tlee10333/card-dealer-final-project/README.md

# Automated Card Dealer Machine 
 By: Alex George, Ike Walker, Trinity Lee, Mo Ampane
## Principles of Integrated Engineering Final Group Project 

Our Project is to develop a automated card dealing machine using an Arduino Uno, a stepper Motor (NEMA 12 V), and a DC Motor.
