tlee10333/card-dealer-final-project/docs/pages/gallery.md

---
layout              : page-fullwidth
title               : "Gallery"
subheadline         : "Pictures &amp; Videos"
teaser              : "A gallery documenting visually our team's progress, from whiteboard sketches to prototypes."
header:
   image_fullwidth  : "header_roadmap_3.jpg"
permalink           : "/gallery/"

image:
   thumb: cadassembly-thumb.jpg
gallery:
    - image_url: cadassembly.jpg
      caption: The finished CAD of our card dealer with turning gear(not integrated into table)
    - image_url: action_shot.jpg
      caption: A picture of our final card dealer product in action  
    - image_url: bottom_pan_cad.jpg
      caption: A CAD layout of the bottom gears
    - image_url: dealer_side2.jpg
      caption: Picture of the card dealer with panning mechanism (before shroud)
    - image_url: IMG_5724.jpg
      caption: Picture of the card dealer fully integrated with the central column
    - image_url: isometric_pan_cad.jpg
      caption: CAD image of the elgonated support legs and panning mechanism
    - image_url: just_shooter.jpg
      caption: Our complete electrical integration of all motors and LCD Screen
    - image_url: lcd.jpg
      caption: An image of the final integrated LCD screen with buttons into the shroud   
    - image_url: schematic.jpg
      caption: Our Block Diagram showing the flow of actions for our system
    - image_url: schematic_diagram.jpg
      caption: The entire electrical system schematic diagram
    - image_url: table_complete_isometric.jpg
      caption: The complete Table (before integration)
    - image_url: cadassembly_table.jpg
      caption: A CAD screenshot of full table and card dealer integration
    - image_url: painted_center_support.jpg
      caption: A painted central support
    - image_url: product_image_2.jpg
      caption: Finished table and integrated card dealer being used by team members
    - image_url: product_image_3.jpg
      caption: Our integrated card dealer in action
    - image_url: real_dealer1.jpg
      caption: Close up of automatic card dealer (sans shroud) with cards
    - image_url: real_dealer2.jpg
      caption: Close up of automatic card dealer (sans shroud) without cards
    - image_url: caddealer.jpg  
      caption: CAD image of just the card dealing mechanism 
    - image_url: caddealershroud.jpg
      caption: CAD image of card dealing mechanism with shroud
    - image_url: internal_gear.jpg
      caption: Top view of turning gear mechanism setup
---

{% include gallery %}
