tlee10333/card-dealer-final-project/docs/_posts/system/2023-10-13-electrical.md

---
layout: page-fullwidth
title: "Electrical System Overview"
subheadline: "Overview"
teaser: "An overview of the Electrical System of the Automatic Card Dealer."
categories:
    - system
show_meta: false
header:
    title: Electrical System
    background-color: "#EFC94C;"
    image_fullwidth: IMG_5722.jpg

---
<!--more-->

## Harnessing & Electrical System Overview

At the core of our electrical system, we use an `Arduino Uno` and an `Adafruit Motor Shield v2` placed directly on top of the Arduino to drive all hardware and firmware. The Motor shield has the capacity to drive up to 4 DC motors or two stepper motors, so for our product, it was the perfect amount since we needed one stepper motor and one DC motor. 

On top of the motors, we also needed to use buttons with pull up resistors (debounce was handled in firmware)
Here is a schematic diagram that was used to keep track of all the harnessing and wiring for the auto dealer. It also lists on the right hand side the different pins used and the corresponding wiring for it.  

<div class="row ">
    <div class="columns">
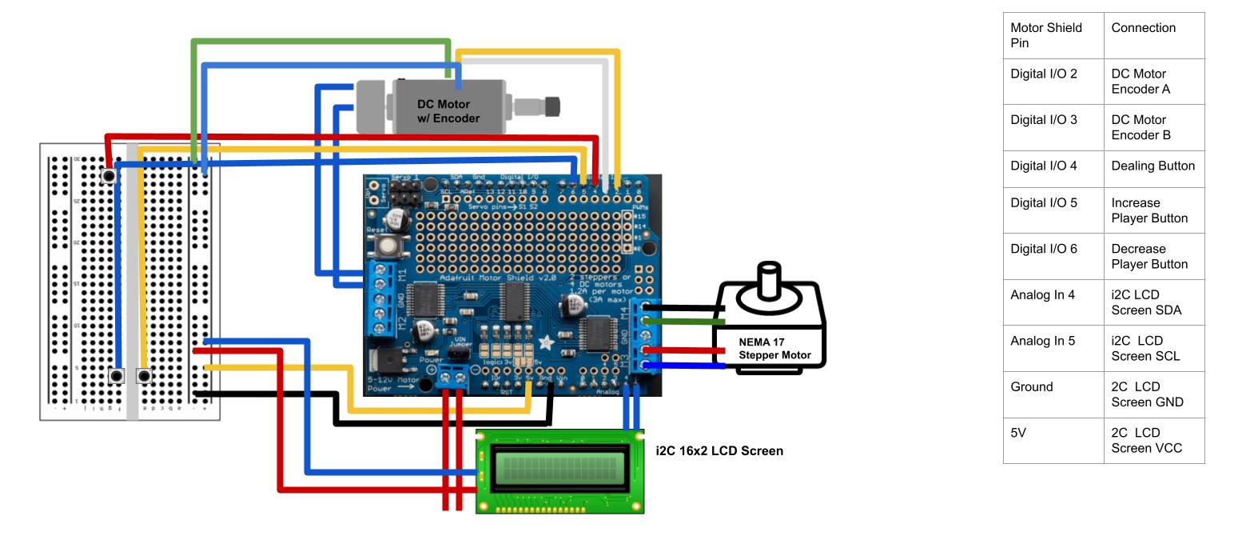
[picture p32: docs/images/schematic_diagram.jpg]
        <center>
        <p><i>  A schematic diagram of our electrical system </i></p></center>
    </div><!-- /.columns -->
</div><!-- /.row -->

This is integrated into the actual card dealer, with the arduino, motor shield, and breadboard living right under the card dealer and on the pan mechanism. Note that Digital I/O pins are used only for the encoder and the three different buttons, while the LCD screen uses Analog pins for the i2C protocol. 

<div class="row ">
    <div class="columns">
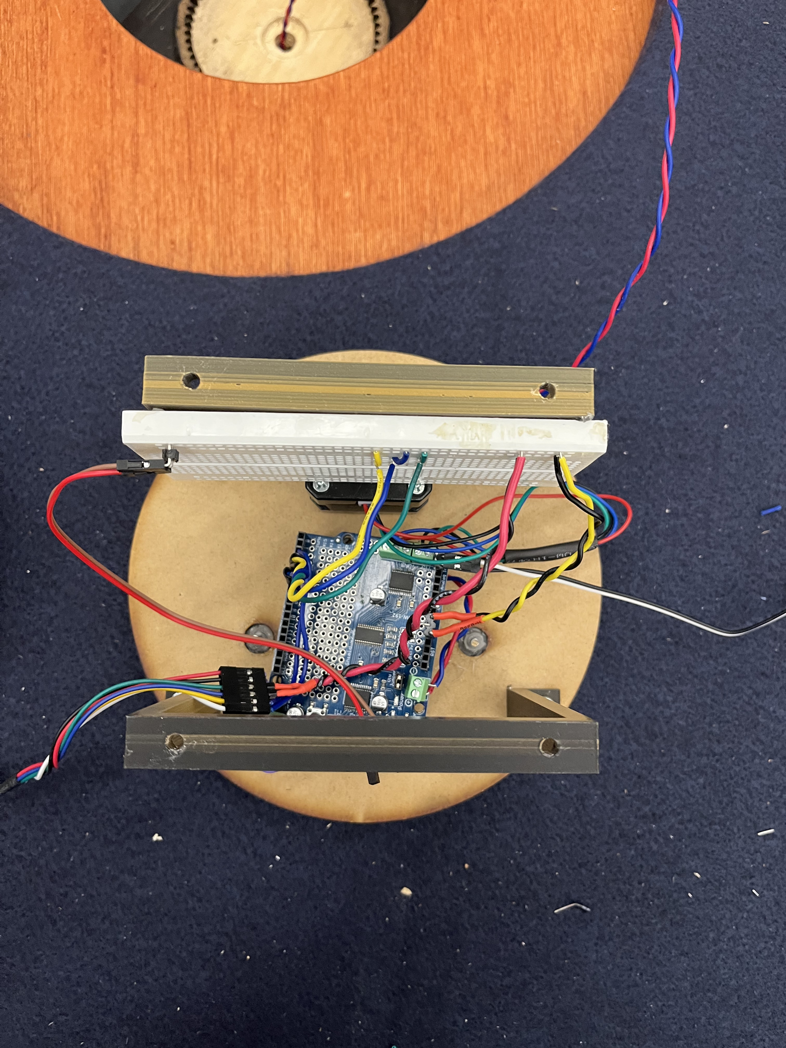
[picture p33: docs/images/IMG_5738.jpg]
        <center>
        <p><i>  A topview of our integrated electrical system </i></p></center>
    </div><!-- /.columns -->
</div><!-- /.row -->

The buttons and LCD Screen are embedded into the shroud, with wires soldered onto the buttons. The Arduino and the motor shield is powered through a AC power supply that is directly connected to the motor shield. The wires connecting the AC power supply to the Arduino go through a hole into the central column. 

<center>
<div class="row t60">
    <div class="medium-6 columns b30">
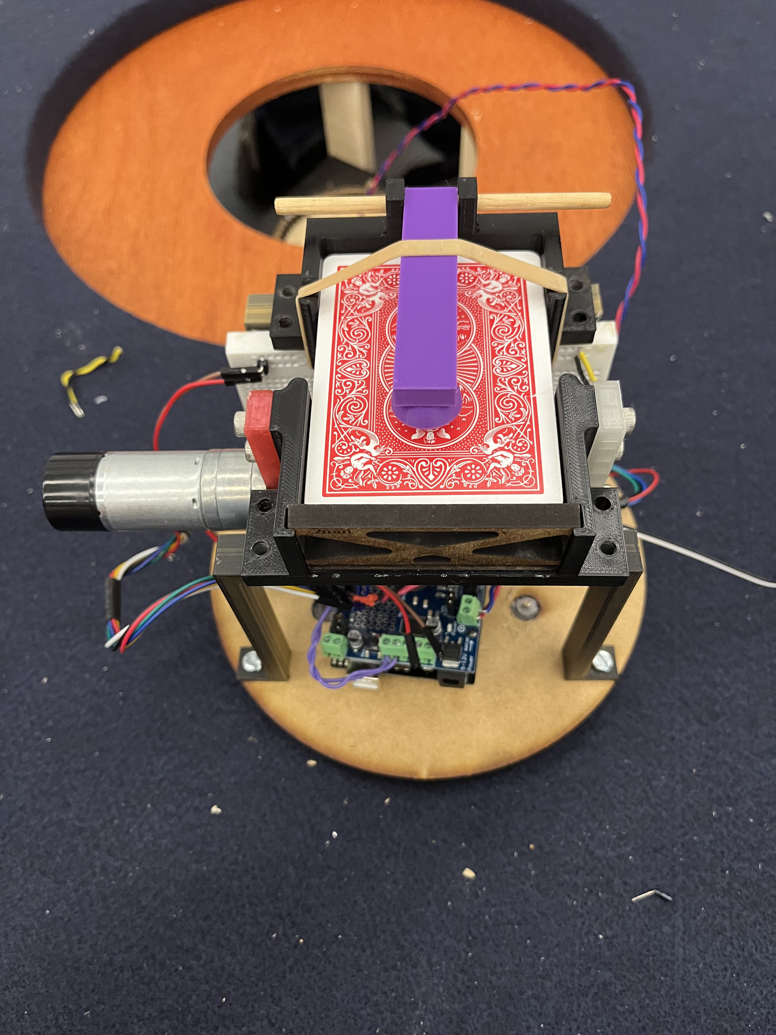
[picture p34: docs/images/IMG_5739.jpg]
        
        <p><i>All electrical harnessing  integrated</i></p>
    </div><!-- /.medium-6.columns -->

    <div class="medium-6 columns b30">
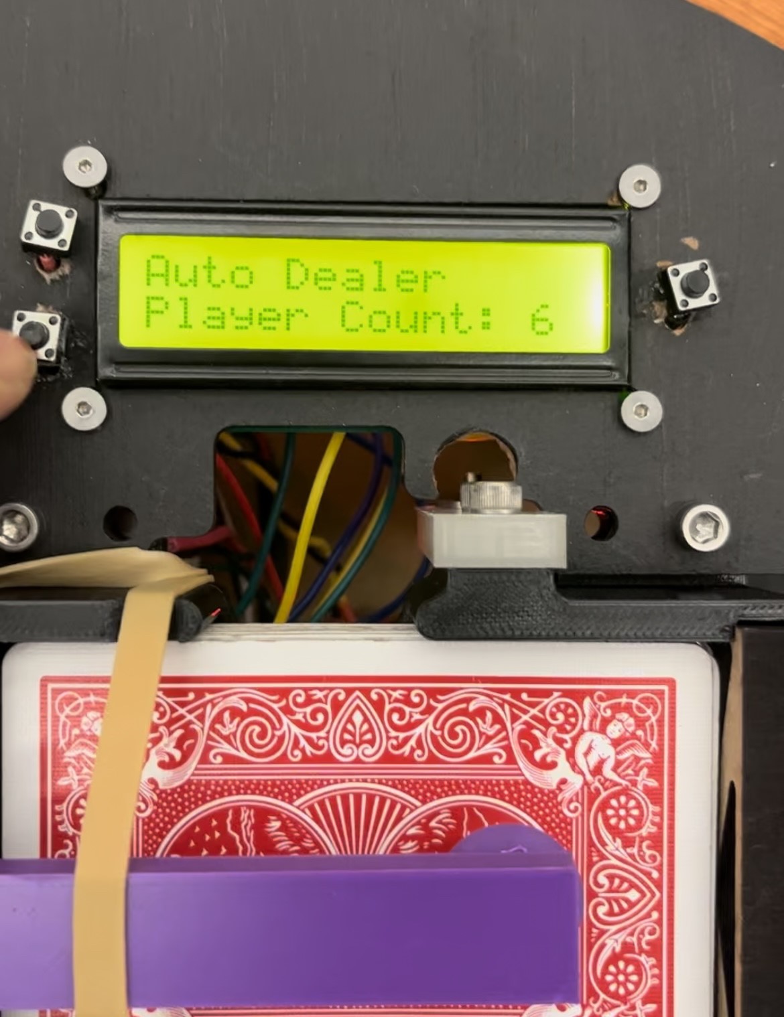
[picture p35: docs/images/lcd.jpg]
        
        <p><i>The LCD & buttons embedded into the shroud</i></p>
    </div><!-- /.medium-6.columns -->
</div><!-- /.row -->
</center>

The three buttons next to the LCD control the number of players and trigger dealing. The LCD is an 16x2 using an i2C protocol driver to simplify wiring with a serial Clock pin (SCL) and serial data pin (SDA) that handles all updates for the LCD Screen. The arduino Uno pins for i2C pins are Analog pins A4 and A5, as shown connected in the schematic diagram above.  

 One of the major goals in electrical was organization and longevity. Due to the numerous times when disassembly was required during integration and debugging, making sure that it was easy to know which wires went where was key, meaning that a clean harnessing so that it could all fit under the narrow space between the pan mechanism and the card dealer was crucial. Furthermore, the longevity of the system was critical since replacing wires once integrated was very difficult. Thus, we had to make sure that wires wouldn't accidentally come out or short together and ruin the entire system. To keep the harnessing clean and prevent any shorts, we soldered almost all the wires to male headers and used heatshrink to prevent shorting. We also braided wires and color-coded wires as much as possible to make it easy to keep track of wires. 

<div class="row ">
    <div class="columns">
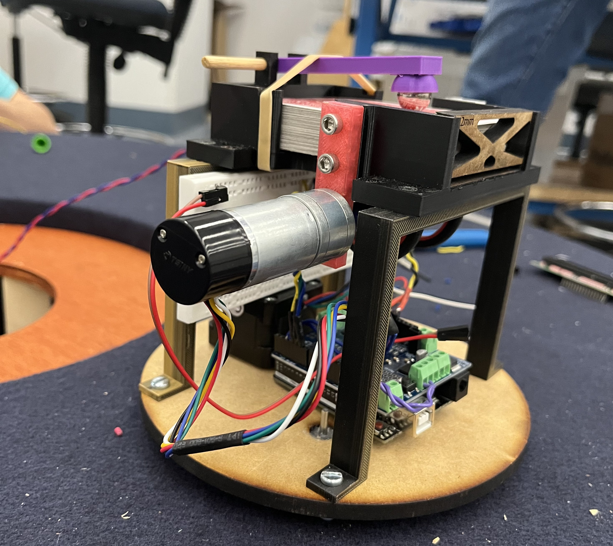
[picture p36: docs/images/IMG_5742.jpg]
        <center>
        <p><i>  Final Electrical Integration (Sans Shroud) </i></p></center>
    </div><!-- /.columns -->
</div><!-- /.row -->
