tlee10333/card-dealer-final-project/docs/pages/sprints.md

---
layout              : page
sidebar: right
title               : "Our Project Progress"
subheadline         : "Sprints"
teaser              : "During the development cycle of the automatic card dealer, our team chose to use an Agile Scrum framework to stay organized and keep track of all the different components needed for our project. Over the course of two to three months, our team went through three sprints total, with each sprint culminating into a design review and retrospective at the end. During each sprint we looked at the status of our Backlog and set concrete goals on what we wanted to achieve at the end of the sprint. Below are the different sprints and progress during each one."
header:
   image_fullwidth  : "scratchwork.jpg"
permalink           : "/sprints/"

widget1:
  title: "Sprint 1"
  url: '/sprints/one/'
  image: widget-1-302x182.jpg
  text: 'The first sprint was an exploration of what we could do to make an automatic card dealer and mastering the basic mechanisms using materials that we had on hand'

widget2:
  title: "Sprint 2"
  url: '/sprints/two/'
  image: widget-1-302x182.jpg
  text: 'This sprint began the pursuit of our reach goals, like LCD Screens, modular players, a table, and a shroud'

widget3:
  title: "Sprint 3"
  url: '/sprints/three/'
  image: widget-1-302x182.jpg
  text: 'The final integration and iteration of our Automatic Card Dealer as well as the final week progress before expo'
---
