tlee10333/card-dealer-final-project/docs/pages/about.md

---
layout: page
title: "Meet the Team"
subheadline: "About"
teaser: "Our engineering team, Almost Straight, is a combination of mechanical, electrical, and software engineers who have come together to build an automatic card dealer"
permalink: "/about/"
header:
    image_fullwidth: "banner.jpg"
---

## Mo Ampane

<div class="row t60">
    <div class="medium-6 columns b30">
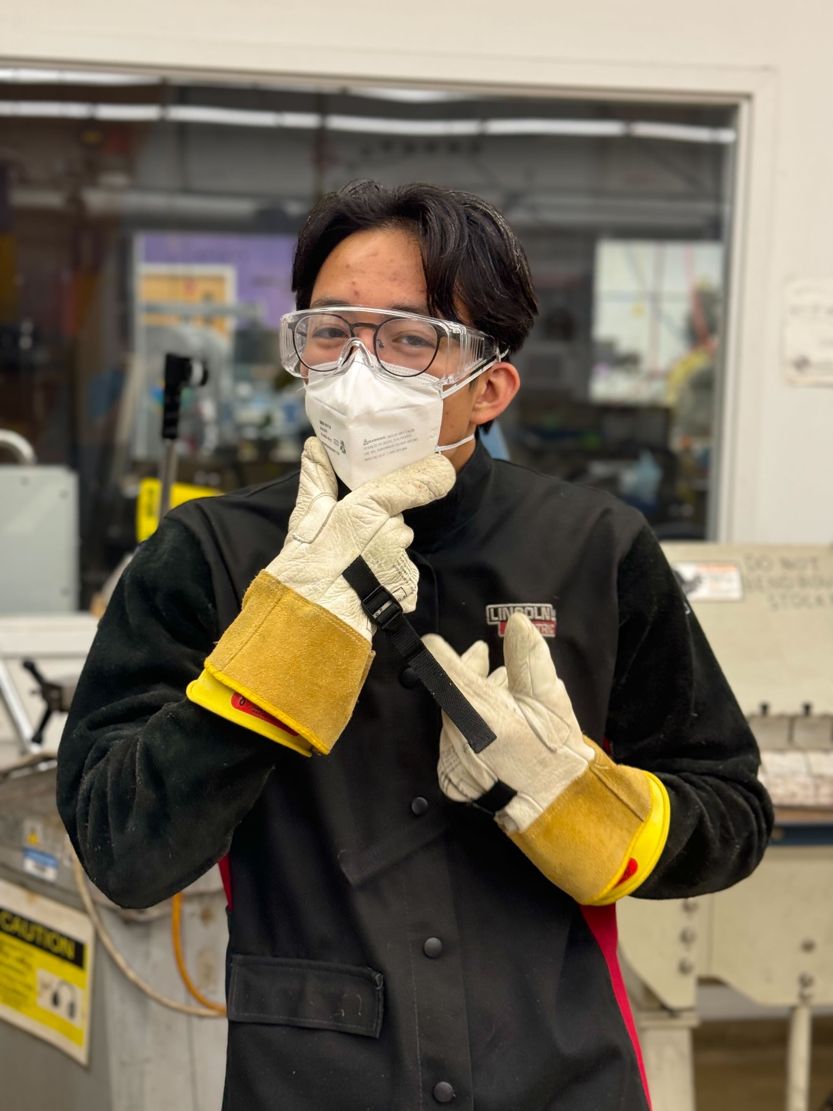
[picture p37: docs/images/mo.JPG]
        
    </div><!-- /.medium-6.columns -->

    <div class="medium-6 columns b30">
        <p>I'm Maurice (Mo) Ampane, a Mechanical Engineer with a software portfolio. My main engineering interests lie in robotics and machine learning. My love for fire spinning is only matched by my love for poker.
 </p>
    </div><!-- /.medium-6.columns -->
</div><!-- /.row -->

## Alex George

<div class="row t60">
    <div class="medium-6 columns b30">
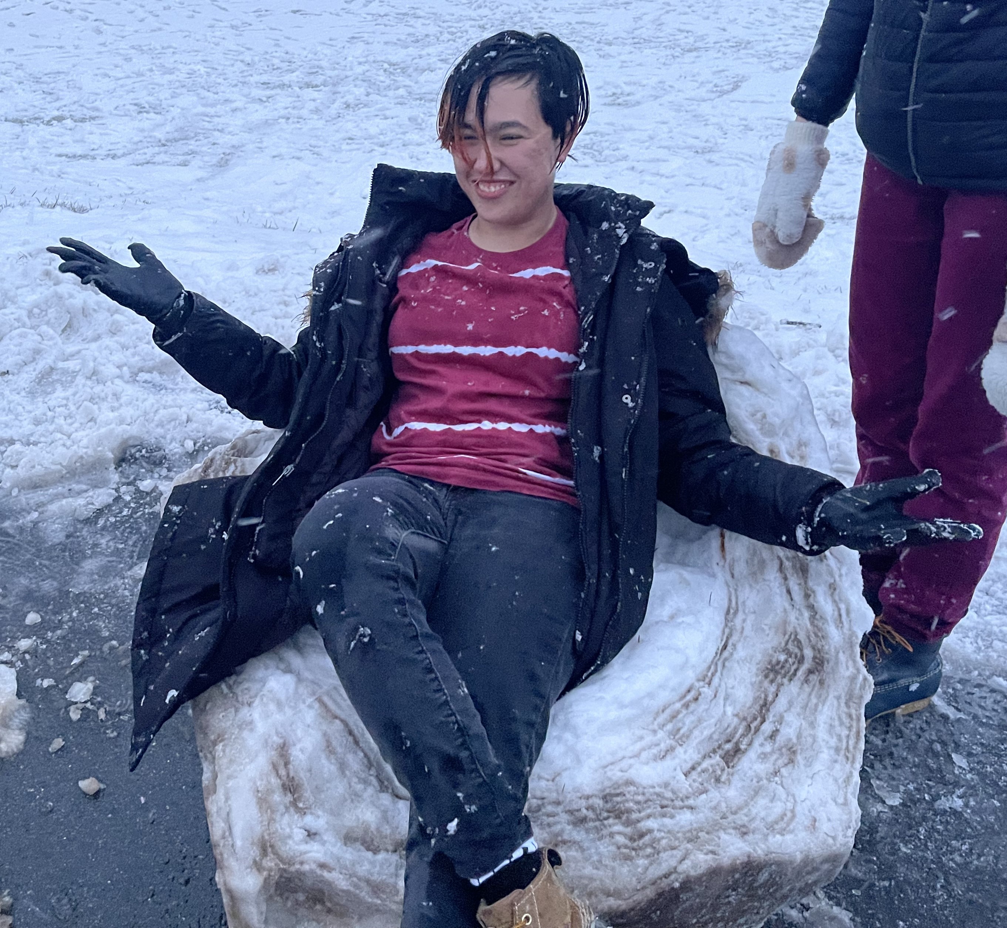
[picture p38: docs/images/alex.jpg]
        
    </div><!-- /.medium-6.columns -->

    <div class="medium-6 columns b30">
        <p>I’m Alex George, a Mechanical Engineer who enjoys dabbling in software. Outside of engineering, I’m a theater nerd who also enjoys spinning fire and, of course, the occasional card game. </p>
    </div><!-- /.medium-6.columns -->
</div><!-- /.row -->

## Ike Walker

<div class="row t60">
    <div class="medium-6 columns b30">
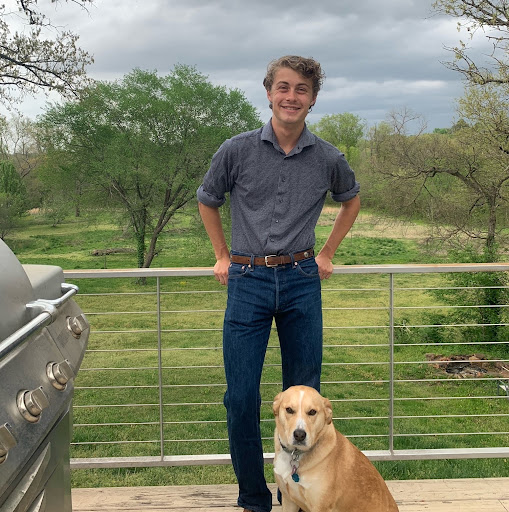
[picture p39: docs/images/hot_man.jpg]
        
    </div><!-- /.medium-6.columns -->

    <div class="medium-6 columns b30">
        <p>I’m Ike Walker, an Olin Class of ‘26 Mechanical Engineer. I have a particular interest in the fabrication and assembly of mechanical systems, and I was able to bring my experience as a wood and laser shop assistant to helping design and build the central table. In the long run, I want to gear my career towards sustainable energy engineering, but a little cards on the side never hurt.
</p>
    </div><!-- /.medium-6.columns -->
</div><!-- /.row -->

## Trinity Lee

<div class="row t60">
    <div class="medium-6 columns b30">
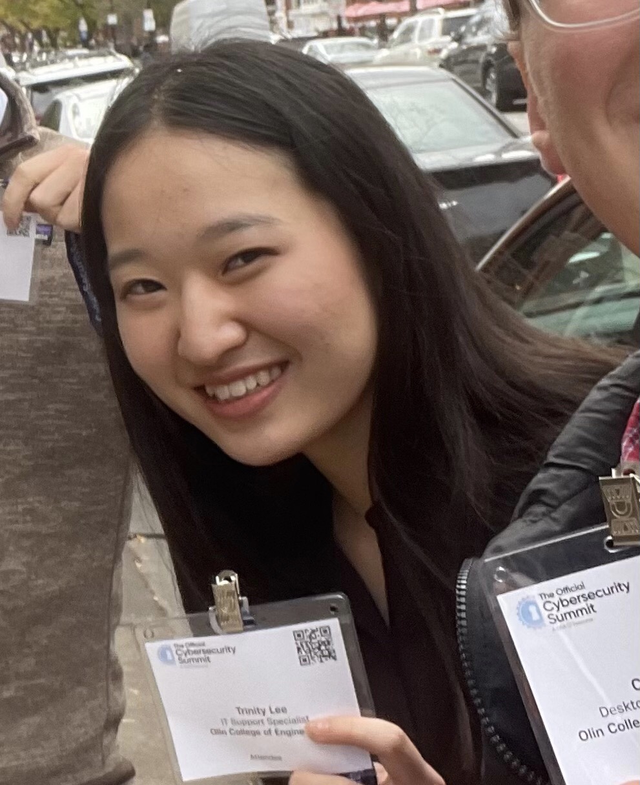
[picture p40: docs/images/trinity.jpg]
        
    </div><!-- /.medium-6.columns -->

    <div class="medium-6 columns b30">
        <p>I'm Trinity Lee, a computer engineer who enjoys spending their spare time doing offensive cybersecurity and helping build electric racecars. For this project, I used my background in firmware, electrical engineering, and software for this project's firmware and electrical systems. If I'm not competing in a CTF or coding something, I'm probably going thrifting or playing card games in my free time! </p>
    </div><!-- /.medium-6.columns -->
</div><!-- /.row -->
