tlee10333/card-dealer-final-project/docs/pages/pages-root-folder/index.md

---

layout: frontpage
header:
  image_fullwidth: product_image_1.jpg
widget1:
  title: "About Us"
  url: '/about/'
  image: almost_straight2.jpg
  text: 'Our team is made up of four engineers from a diverse set of backgrounds to develop a product that is the intersection between mechanical, electrical, and software engineering.'

widget2:
  title: "Our Project"
  url: '/project/'
  text: 'The Automatic Card Dealer is an innovative way to deal cards for card games without human error and maximum efficiency. Centered around human design and seamless integration into the environment, our product is intuitive to use.'
  image: cadassembly.jpg

widget3:
  title: "Progress"
  url: '/sprints/'
  image: schematic.jpg
  text: 'Over the course of two to three months, our team used the Agile Scrum framework and went through three sprints total, with each sprint culminating into a design review. Read more about our sprint and progress throughout the sprints.'
#
#
callforaction:
  url: /gallery/
  text: Gallery ›
  style: alert
permalink: /index.html
#
# This is a nasty hack to make the navigation highlight
# this page as active in the topbar navigation
#
homepage: true
---
