tlee10333/card-dealer-final-project/docs/images/action_shot-thumb.jpg

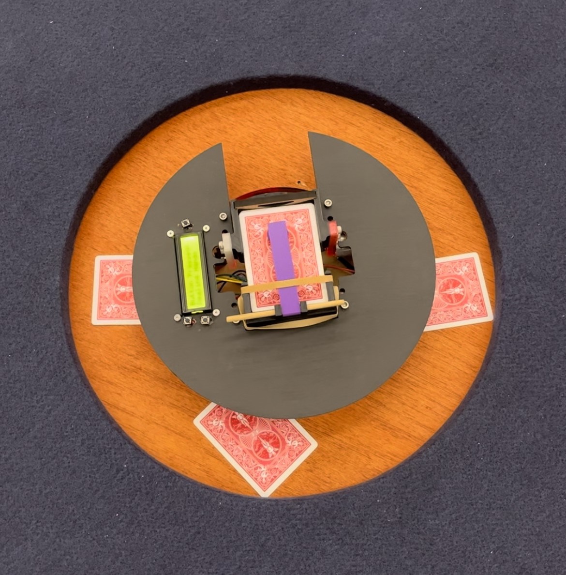
docs/images/action_shot-thumb.jpg
