tlee10333/card-dealer-final-project/docs/images/almost_straight1.jpg

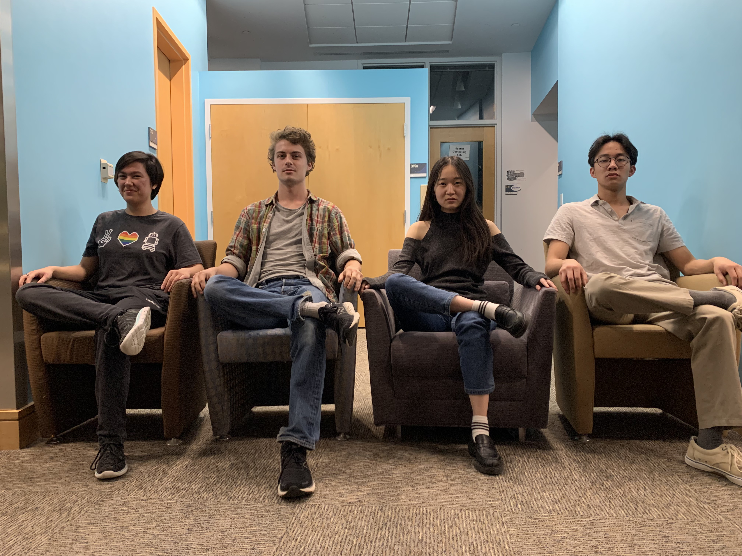
docs/images/almost_straight1.jpg
