tlee10333/card-dealer-final-project/docs/images/almost_straight2.jpg

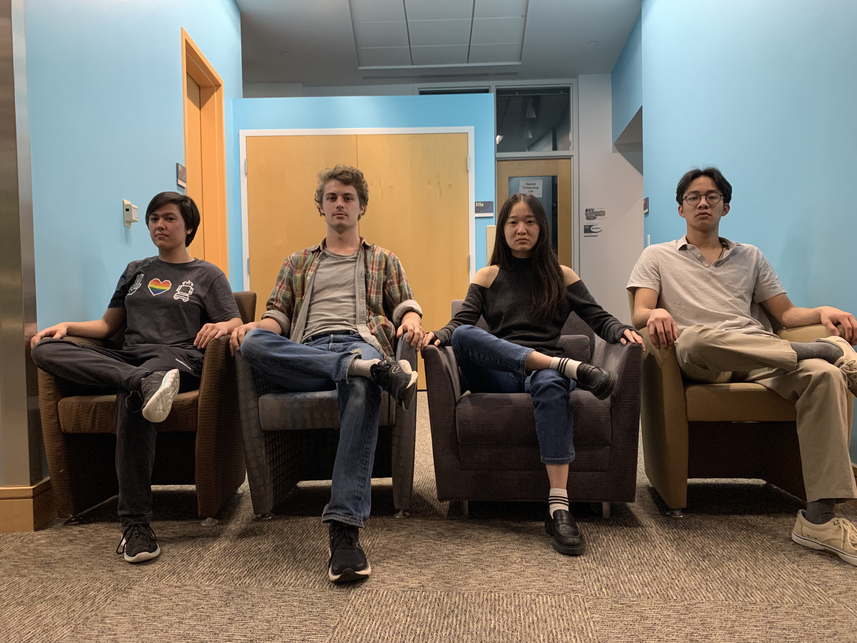
docs/images/almost_straight2.jpg
