tlee10333/card-dealer-final-project/docs/images/almost_straight4.jpg

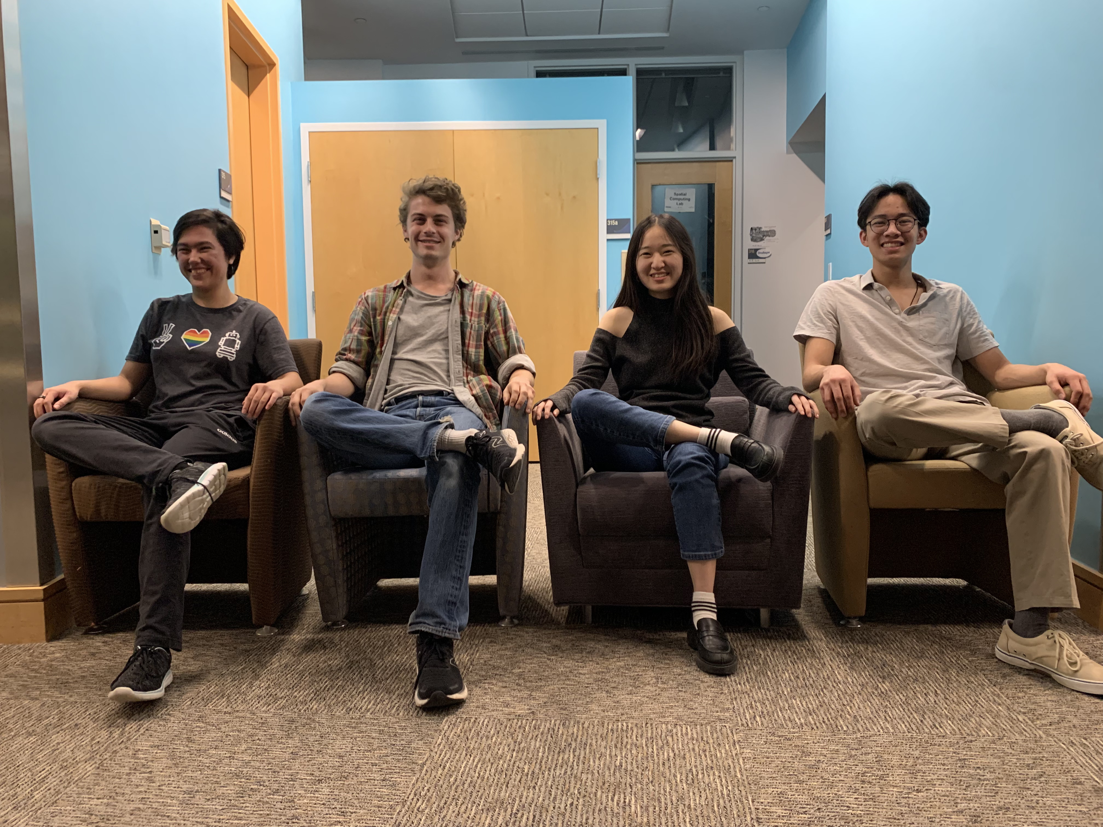
docs/images/almost_straight4.jpg
