tlee10333/card-dealer-final-project/docs/images/almost_straightlol.jpg

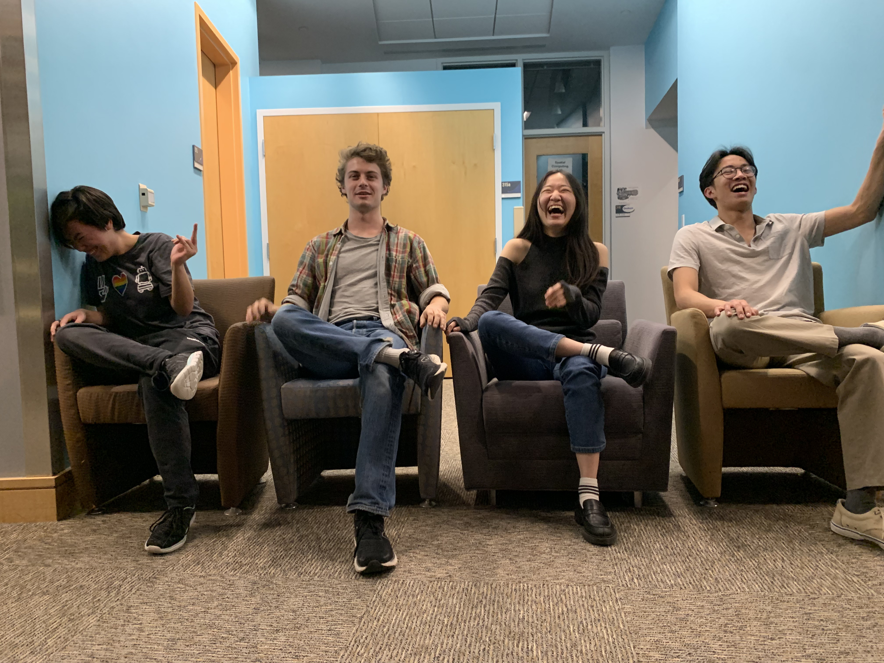
docs/images/almost_straightlol.jpg
