tlee10333/card-dealer-final-project/docs/images/caddealer-thumb.jpg

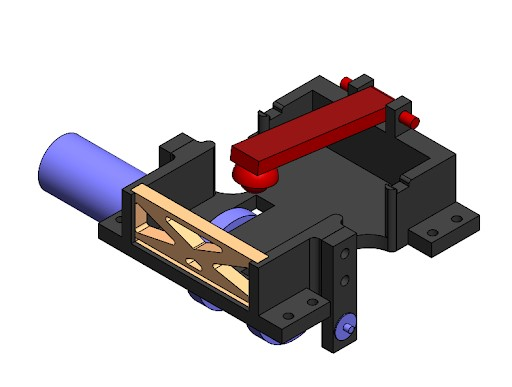
docs/images/caddealer-thumb.jpg
