tlee10333/card-dealer-final-project/docs/images/dealer_side.jpg

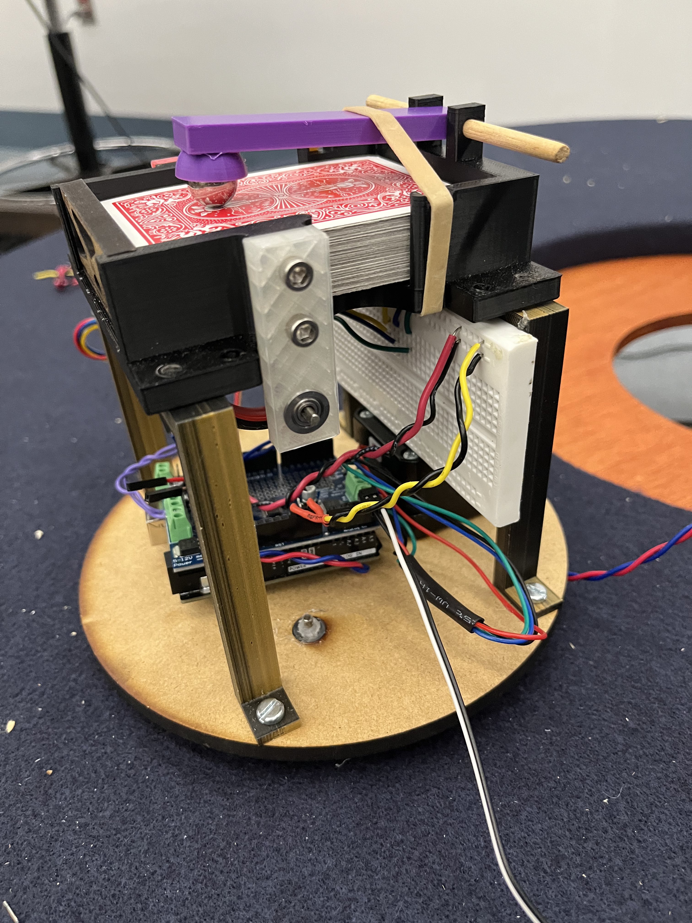
docs/images/dealer_side.jpg
