tlee10333/card-dealer-final-project/docs/images/electrical.jpg

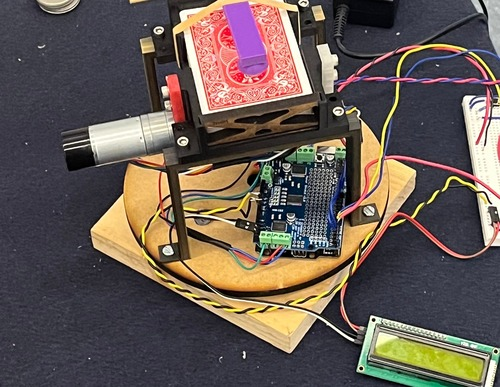
docs/images/electrical.jpg
