tlee10333/card-dealer-final-project/docs/images/firmware.jpg

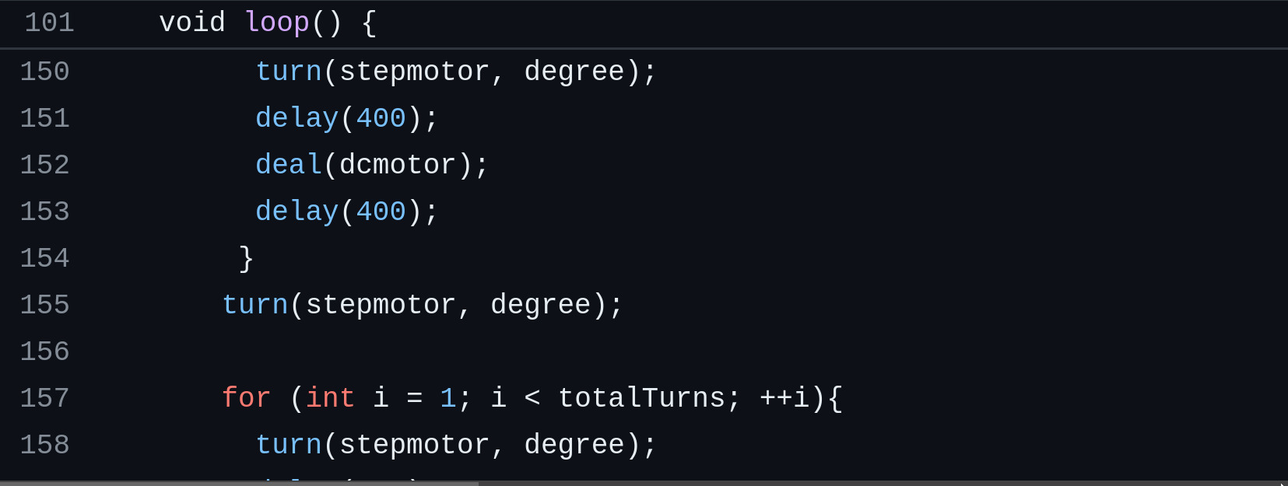
docs/images/firmware.jpg
