tlee10333/card-dealer-final-project/docs/images/IMG_5726.jpg

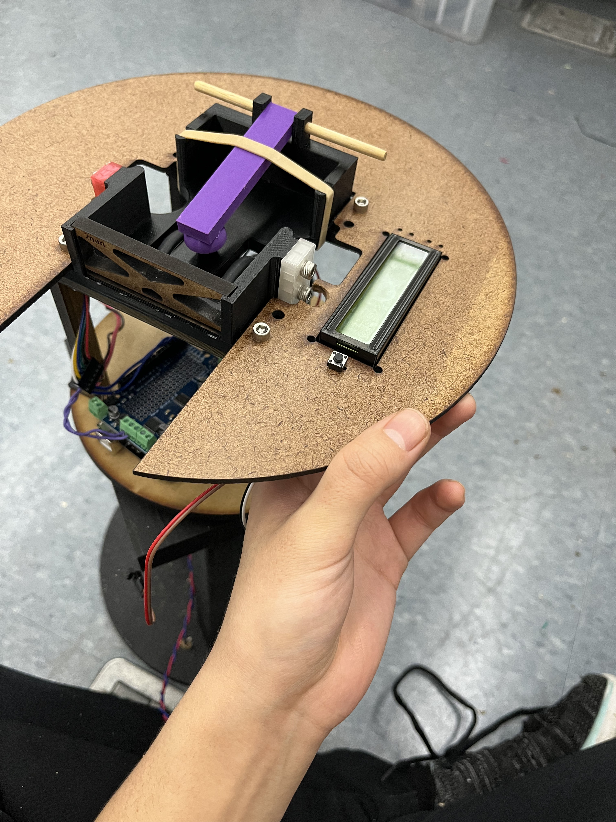
docs/images/IMG_5726.jpg
