tlee10333/card-dealer-final-project/docs/images/mechanical.jpg

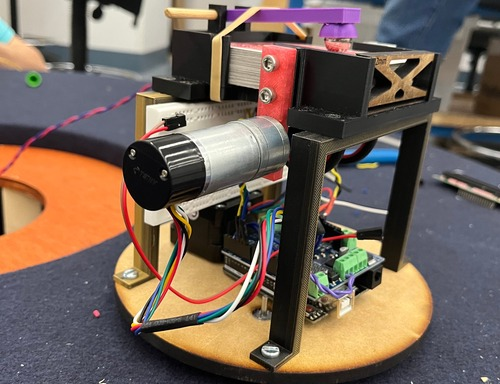
docs/images/mechanical.jpg
