tlee10333/card-dealer-final-project/docs/images/poker.jpg

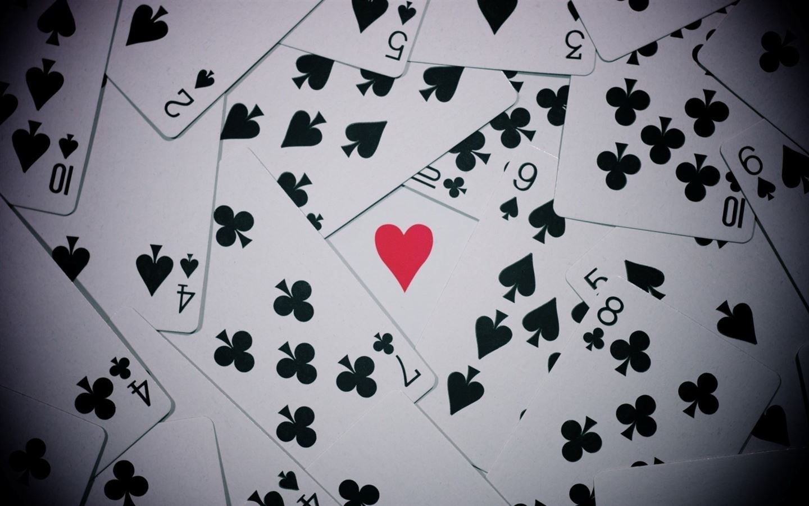
docs/images/poker.jpg
