tlee10333/card-dealer-final-project/docs/images/product_image_2-thumb.jpg

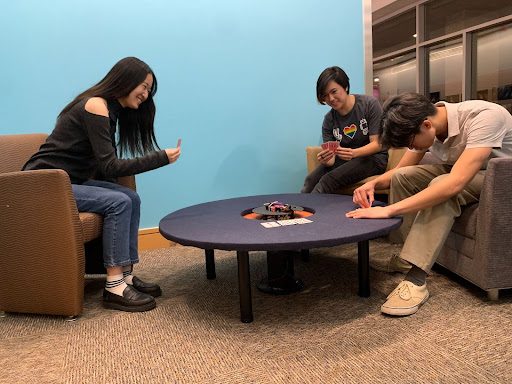
docs/images/product_image_2-thumb.jpg
