tlee10333/card-dealer-final-project/docs/images/product_image_3-thumb.jpg

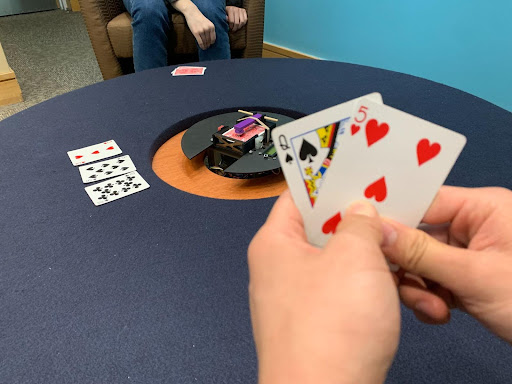
docs/images/product_image_3-thumb.jpg
