tlee10333/card-dealer-final-project/docs/images/refactor.png

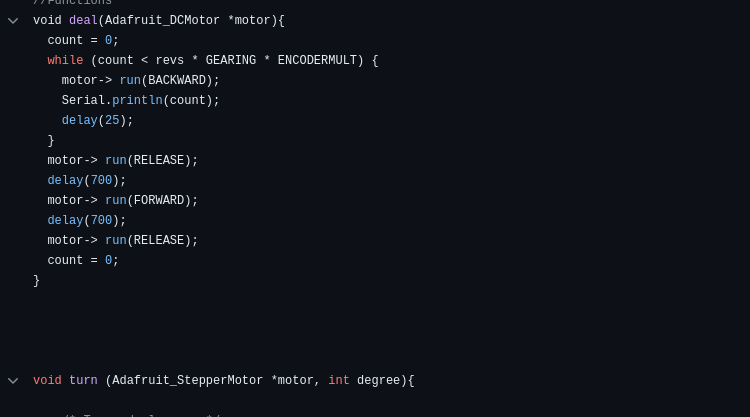
docs/images/refactor.png
