tlee10333/card-dealer-final-project/docs/images/scratchwork.jpg

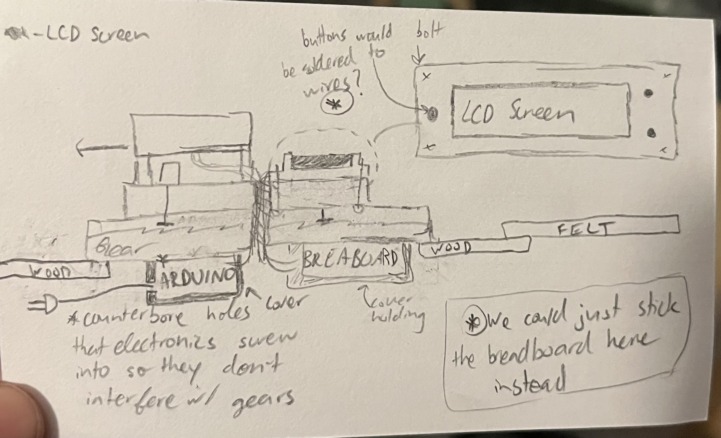
docs/images/scratchwork.jpg
