tlee10333/card-dealer-final-project/Card Shooter.SLDASM

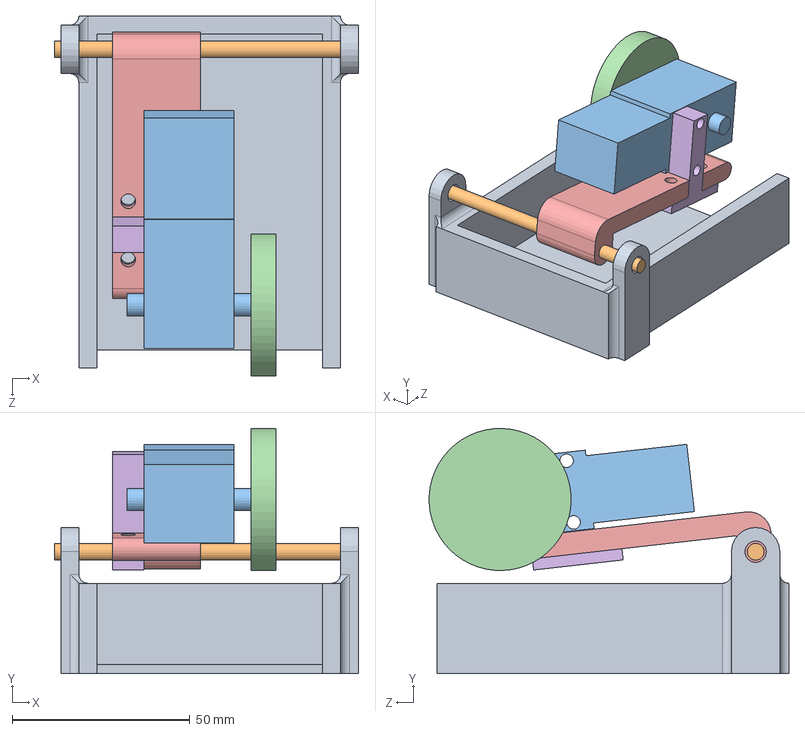
[picture p62: CAD file, 2023-12-09]
Card Shooter.SLDASM
85.6 x 69.0 x 101.3 mm
Deck Holder
Pivot Rod
MP3 Motor
New Wheel
Pivot Arm New Wheel
Motor Mount New Wheel
