tlee10333/card-dealer-final-project/Final CAD Files/Shooter and Pan.SLDASM

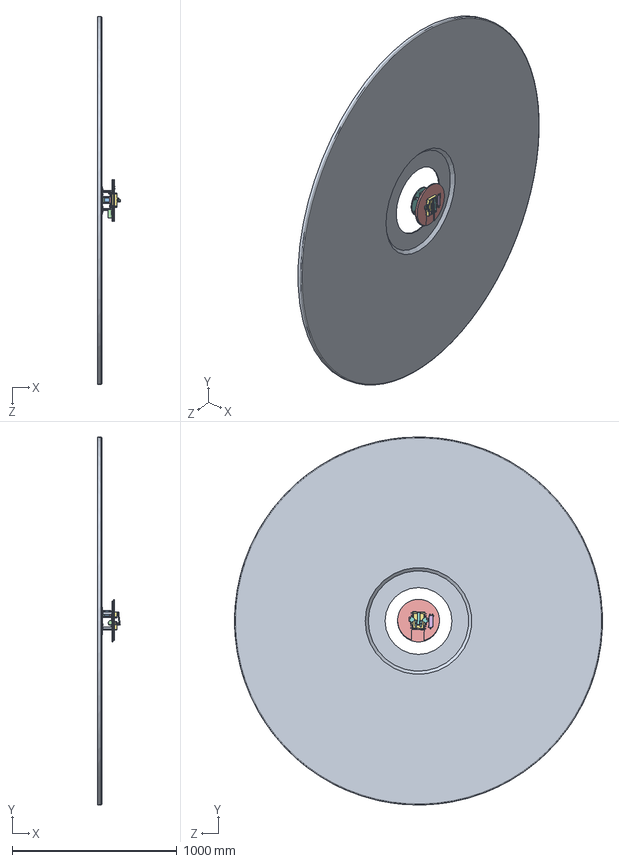
[picture p63: CAD file, 2023-12-15]
Final CAD Files/Shooter and Pan.SLDASM
136.9 x 2234.7 x 2235.2 mm
Shooter Table
Shooter Legs x 2
internal spur gear_ai
NEMA 17 Stepper Motor Middle
NEMA 17 Stepper Motor Top
NEMA 17 Stepper Motor Bottom
NEMA 17 Stepper Motor Shaft
pan cross head_am x 4
spur gear_ai x 3
3mm_bearing x 3
3mm_shaft x 2
3mm_gear_spacer x 2
stepper_shaft_spacer
Main Body
Shaft Hold
Weight Arm
2mm Gate
Encoder Motor
Weight Bearing Ball
Motor Coupler
Shooter 3mm Shaft
Dealer Shroud
LCD_screen
button x 3
Table Top
