tlee10333/card-dealer-final-project/Final CAD Files/Entire Table Top.SLDASM

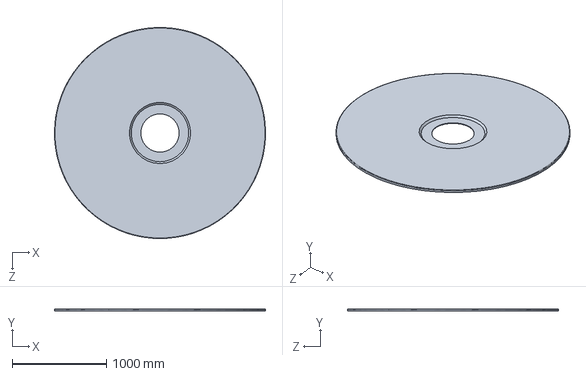
[picture p64: CAD file, 2023-12-15]
Final CAD Files/Entire Table Top.SLDASM
2234.7 x 25.4 x 2235.2 mm
