tlee10333/card-dealer-final-project/Final CAD Files/Sprint 3 Assembly.SLDASM

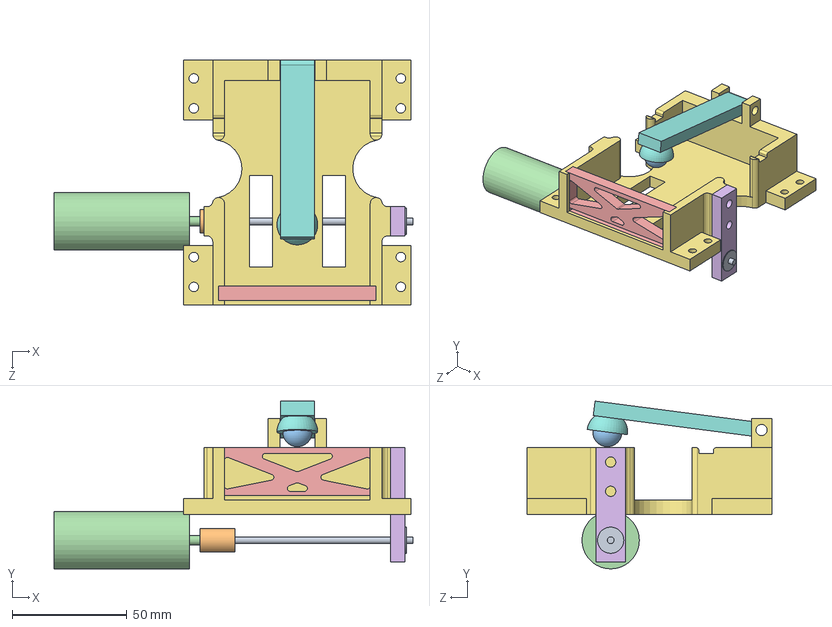
[picture p65: CAD file, 2023-12-15]
Final CAD Files/Sprint 3 Assembly.SLDASM
156.4 x 73.1 x 106.9 mm
Main Body
Shaft Hold
Weight Arm
2mm Gate
Encoder Motor
3mm_bearing
Weight Bearing Ball
Motor Coupler
Shooter 3mm Shaft
