tlee10333/card-dealer-final-project/New Main Body.SLDPRT

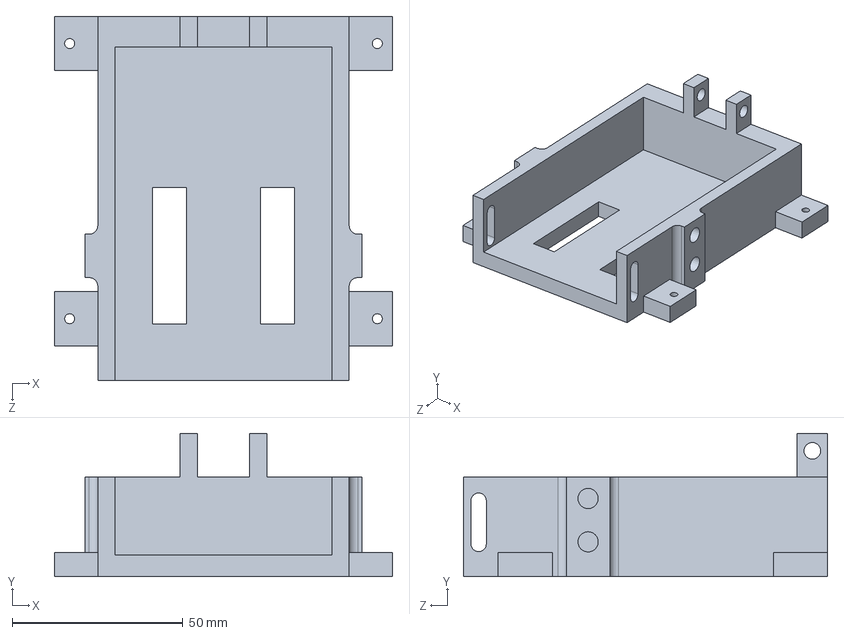
[picture p66: CAD file, 2023-11-28]
New Main Body.SLDPRT
99.1 x 41.9 x 106.7 mm
