tlee10333/card-dealer-final-project/Final CAD Files/Main Body.SLDPRT

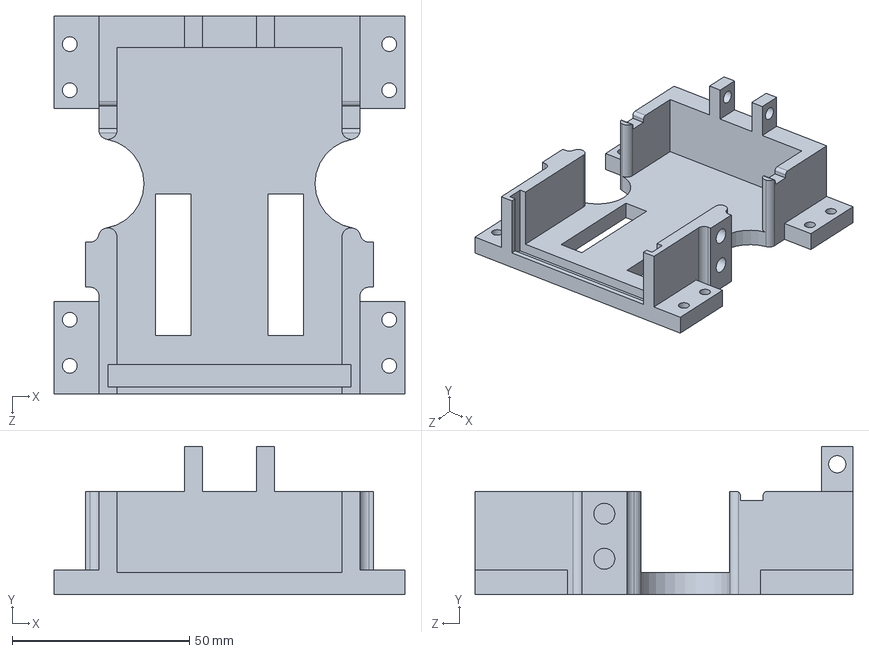
[picture p67: CAD file, 2023-12-15]
Final CAD Files/Main Body.SLDPRT
99.1 x 41.9 x 106.7 mm
