tlee10333/card-dealer-final-project/wheel_connector.SLDASM

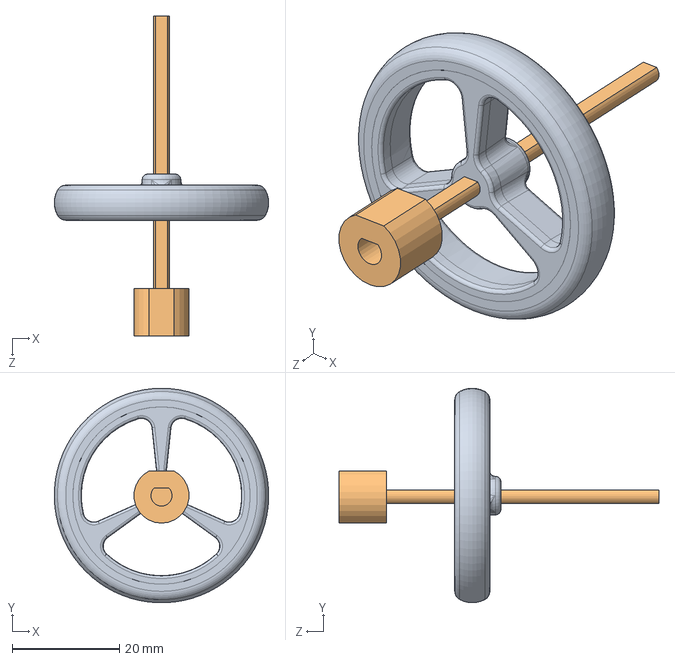
[picture p68: CAD file, 2023-11-09]
wheel_connector.SLDASM
40.0 x 40.0 x 59.7 mm
pololu-wheel-40x7mm-red
wheel_motor_connector
