tlee10333/card-dealer-final-project/MP3 Motor.SLDASM

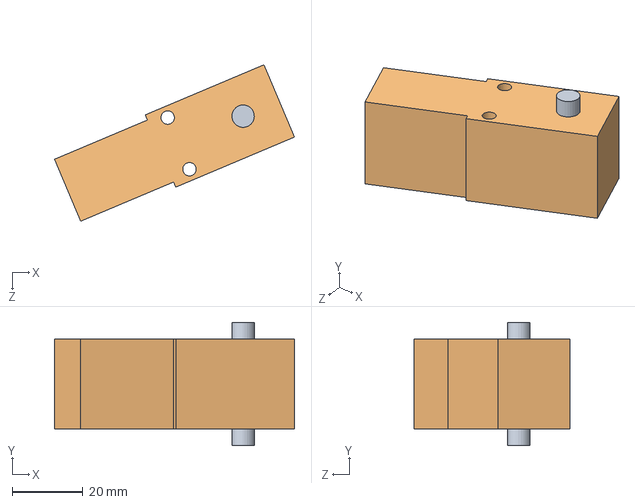
[picture p69: CAD file, 2023-10-29]
MP3 Motor.SLDASM
68.0 x 34.9 x 44.3 mm
MP3 Motor Shaft
MP3 Motor Body
