tlee10333/card-dealer-final-project/Pan Gears.SLDASM

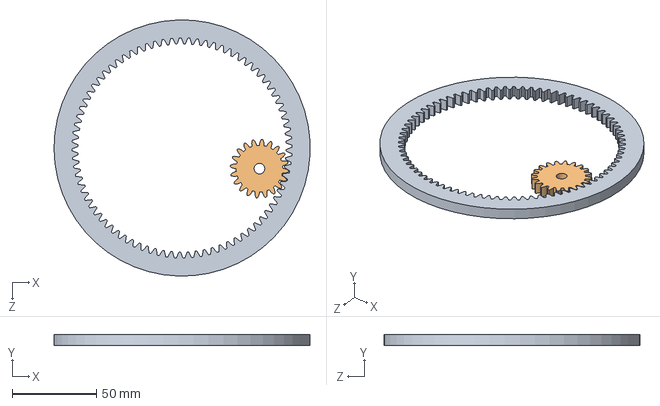
[picture p70: CAD file, 2023-10-23]
Pan Gears.SLDASM
152.3 x 6.35 x 152.3 mm
internal spur gear_ai
spur gear_ai
