tlee10333/card-dealer-final-project/Bearing Plate.SLDPRT

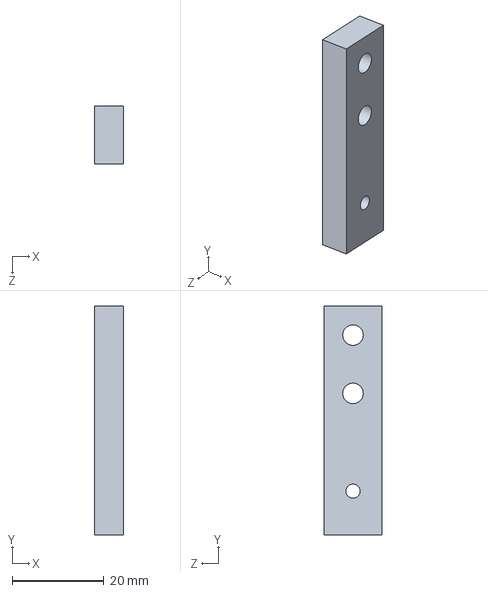
[picture p71: CAD file, 2023-11-28]
Bearing Plate.SLDPRT
6.35 x 49.9 x 12.7 mm
