tlee10333/card-dealer-final-project/Motor.SLDPRT

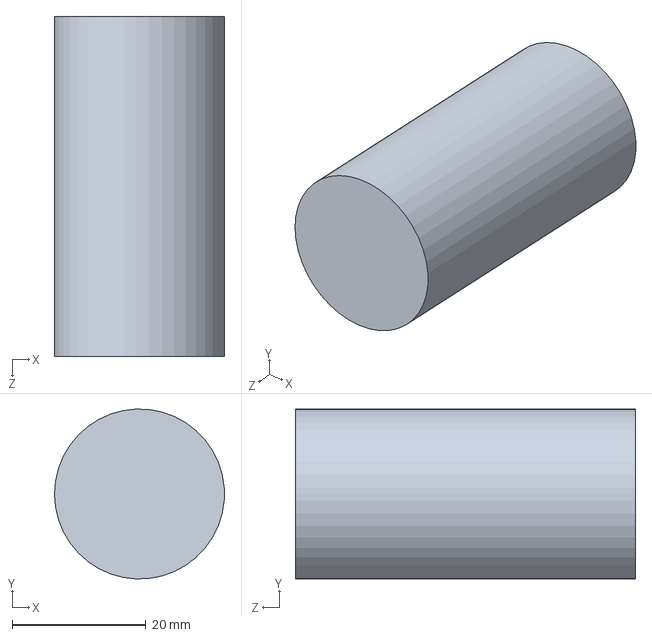
[picture p72: CAD file, 2023-11-28]
Motor.SLDPRT
25.4 x 25.4 x 50.8 mm
