tlee10333/card-dealer-final-project/Weight Arm.SLDPRT

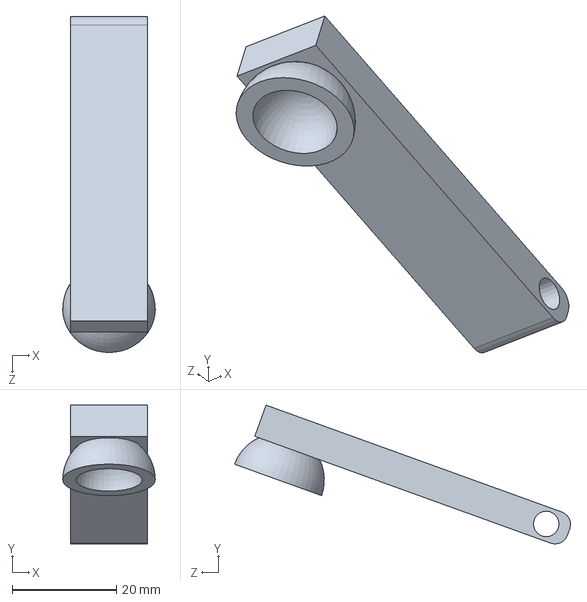
[picture p73: CAD file, 2023-11-28]
Weight Arm.SLDPRT
17.8 x 26.6 x 64.5 mm
