tlee10333/card-dealer-final-project/Final CAD Files/2mm Gate.SLDPRT

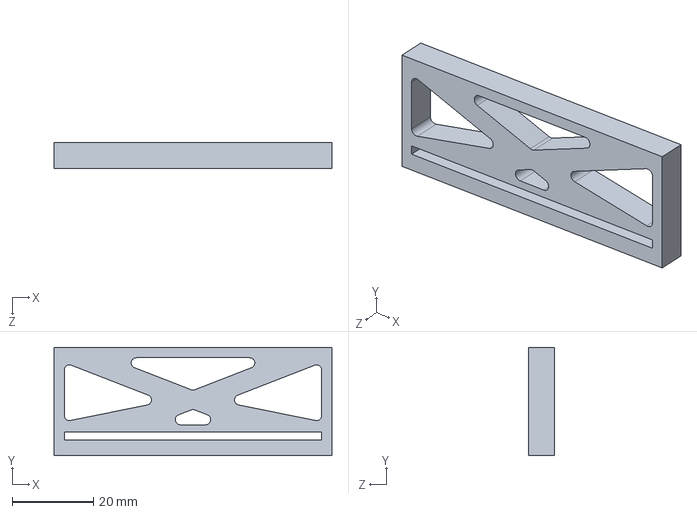
[picture p74: CAD file, 2023-12-15]
Final CAD Files/2mm Gate.SLDPRT
68.6 x 26.7 x 6.35 mm
