tlee10333/card-dealer-final-project/Gate.SLDPRT

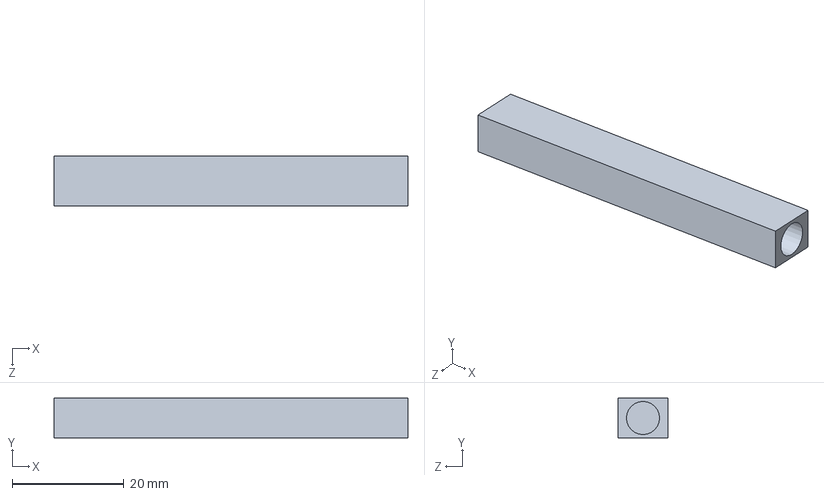
[picture p75: CAD file, 2023-11-28]
Gate.SLDPRT
63.5 x 7.12 x 8.89 mm
