tlee10333/card-dealer-final-project/Final CAD Files/Encoder Motor.SLDPRT

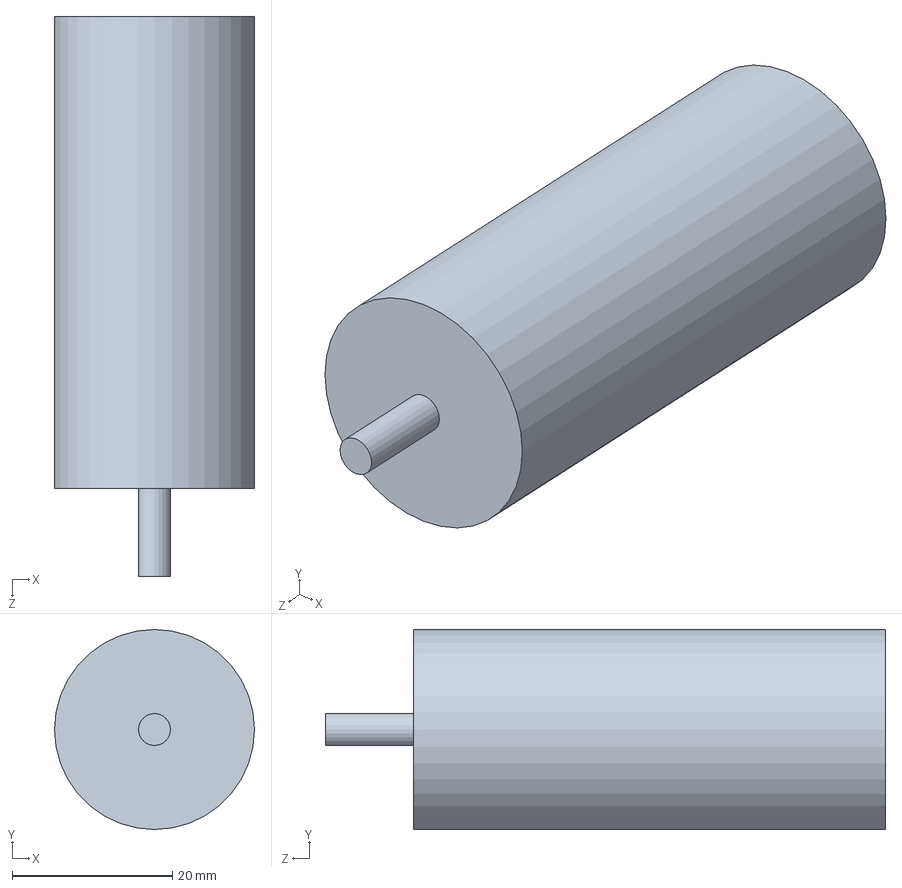
[picture p76: CAD file, 2023-12-15]
Final CAD Files/Encoder Motor.SLDPRT
25.0 x 25.0 x 70.0 mm
