tlee10333/card-dealer-final-project/Final CAD Files/Sprint 3 Multi.SLDPRT

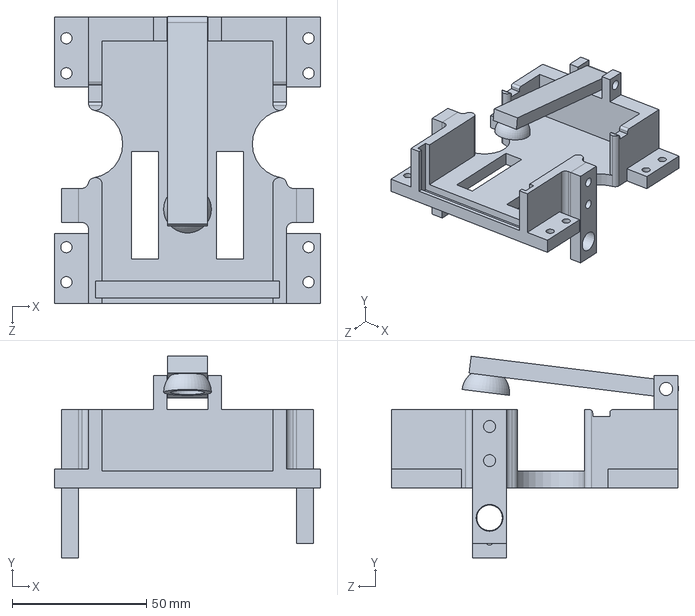
[picture p77: CAD file, 2023-12-15]
Final CAD Files/Sprint 3 Multi.SLDPRT
99.1 x 75.0 x 106.9 mm
