tlee10333/card-dealer-final-project/Mount Plate.SLDPRT

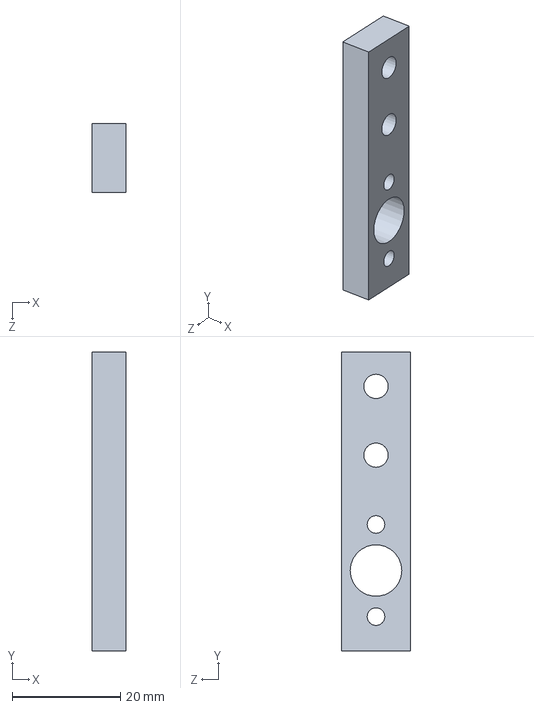
[picture p78: CAD file, 2023-11-28]
Mount Plate.SLDPRT
6.35 x 55.2 x 12.7 mm
