tlee10333/card-dealer-final-project/wheel_motor_connector.SLDPRT

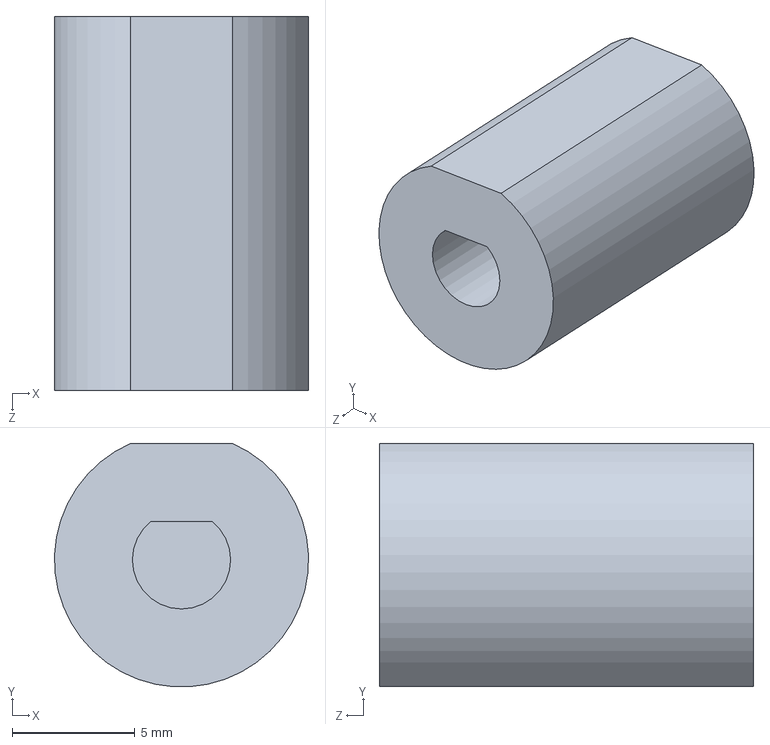
[picture p79: CAD file, 2023-11-28]
wheel_motor_connector.SLDPRT
10.3 x 9.91 x 15.2 mm
