tlee10333/card-dealer-final-project/Final CAD Files/Shooter 3mm Shaft.SLDPRT

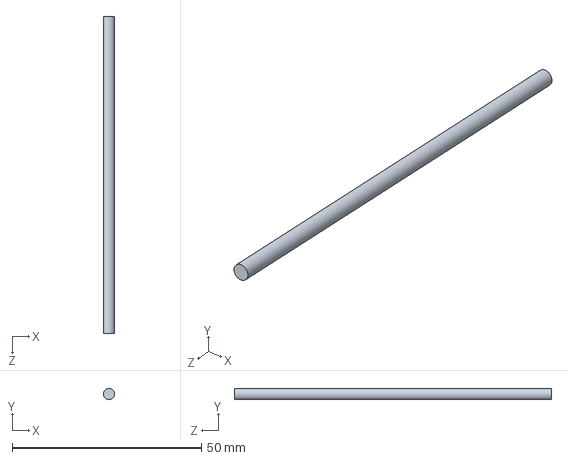
[picture p80: CAD file, 2023-12-15]
Final CAD Files/Shooter 3mm Shaft.SLDPRT
3.00 x 3.00 x 83.8 mm
