tlee10333/card-dealer-final-project/UnderCard Deck Holder.SLDPRT

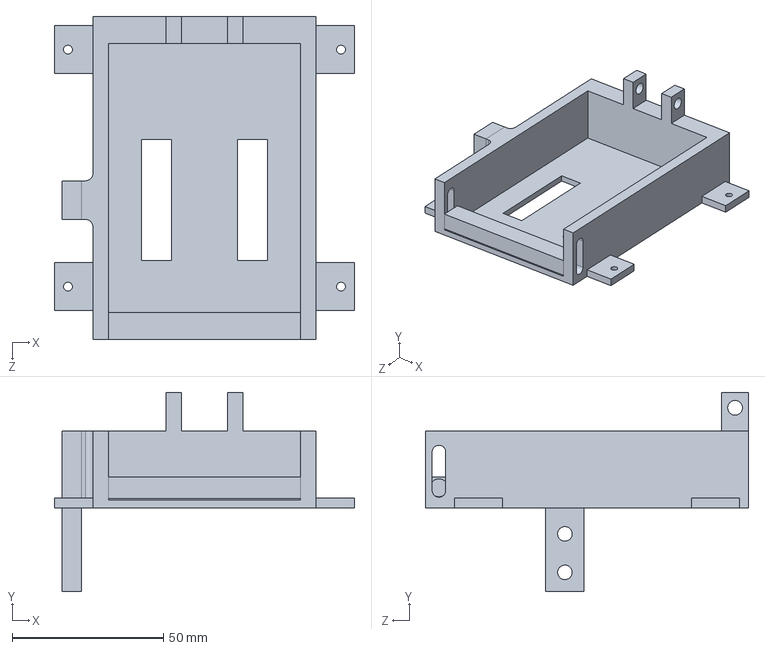
[picture p81: CAD file, 2023-11-14]
UnderCard Deck Holder.SLDPRT
99.1 x 65.8 x 106.7 mm
