tlee10333/card-dealer-final-project/Motor Mount New Wheel.SLDPRT

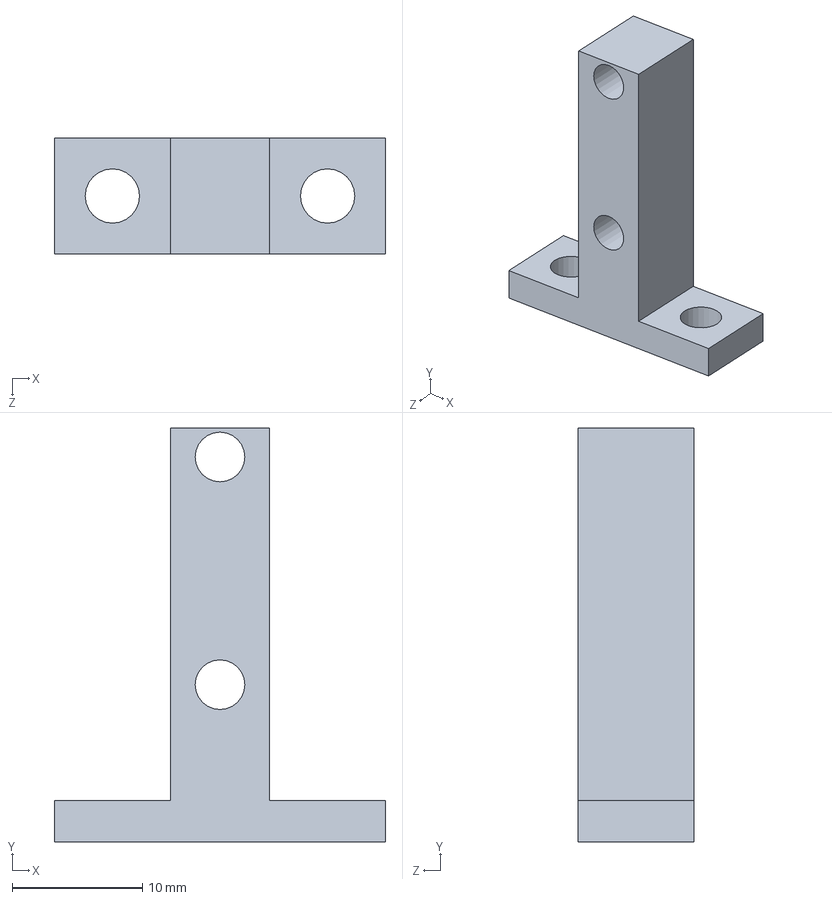
[picture p82: CAD file, 2023-11-14]
Motor Mount New Wheel.SLDPRT
25.4 x 31.8 x 8.89 mm
