tlee10333/card-dealer-final-project/Deck Holder Print V2.STL

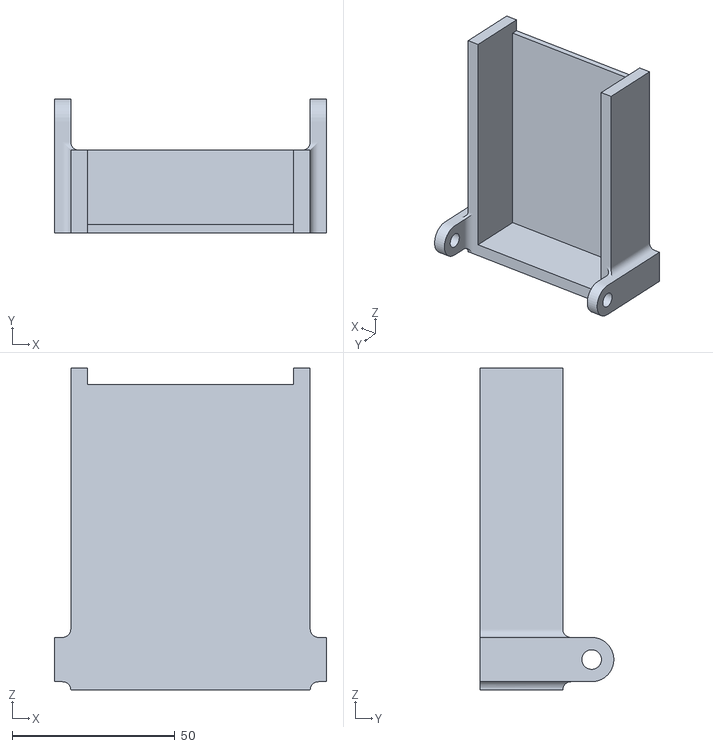
[picture p83: CAD file, 2023-11-14]
Deck Holder Print V2.STL
83.8 x 41.1 x 99.1
