tlee10333/card-dealer-final-project/Pivot Arm Print V2.STL

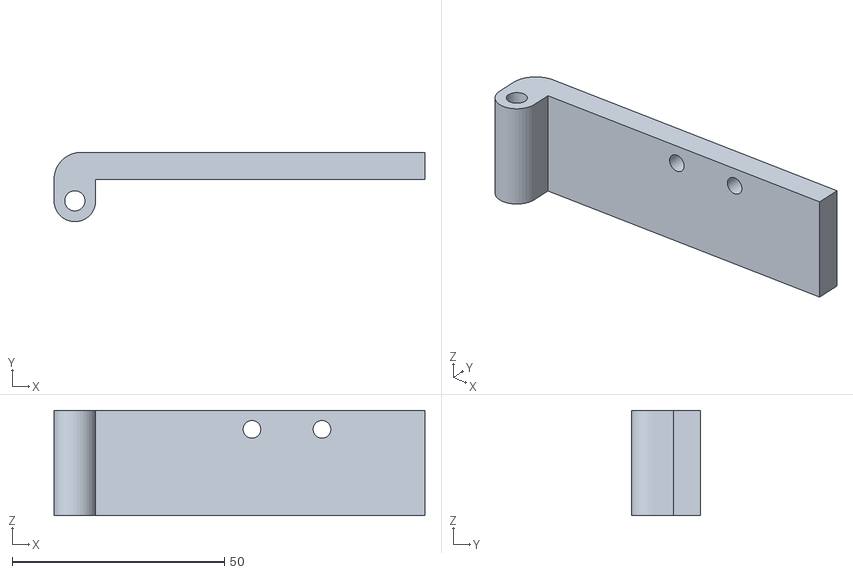
[picture p85: CAD file, 2023-11-14]
Pivot Arm Print V2.STL
87.5 x 16.3 x 24.8
