tlee10333/card-dealer-final-project/Final CAD Files/5mm Gate.SLDPRT

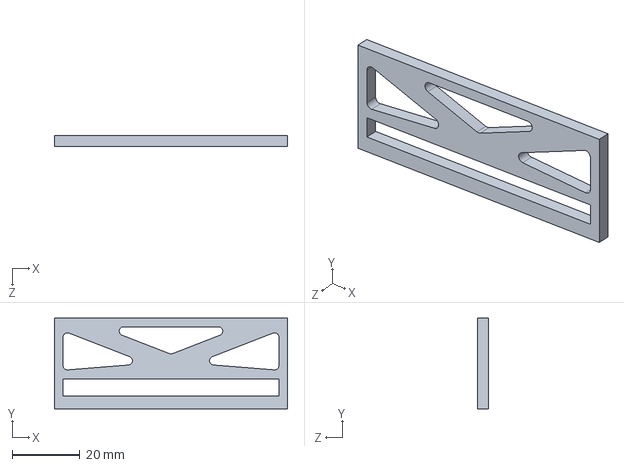
[picture p86: CAD file, 2023-12-15]
Final CAD Files/5mm Gate.SLDPRT
68.6 x 26.7 x 3.17 mm
