tlee10333/card-dealer-final-project/Final CAD Files/Weight Bearing Ball.SLDPRT

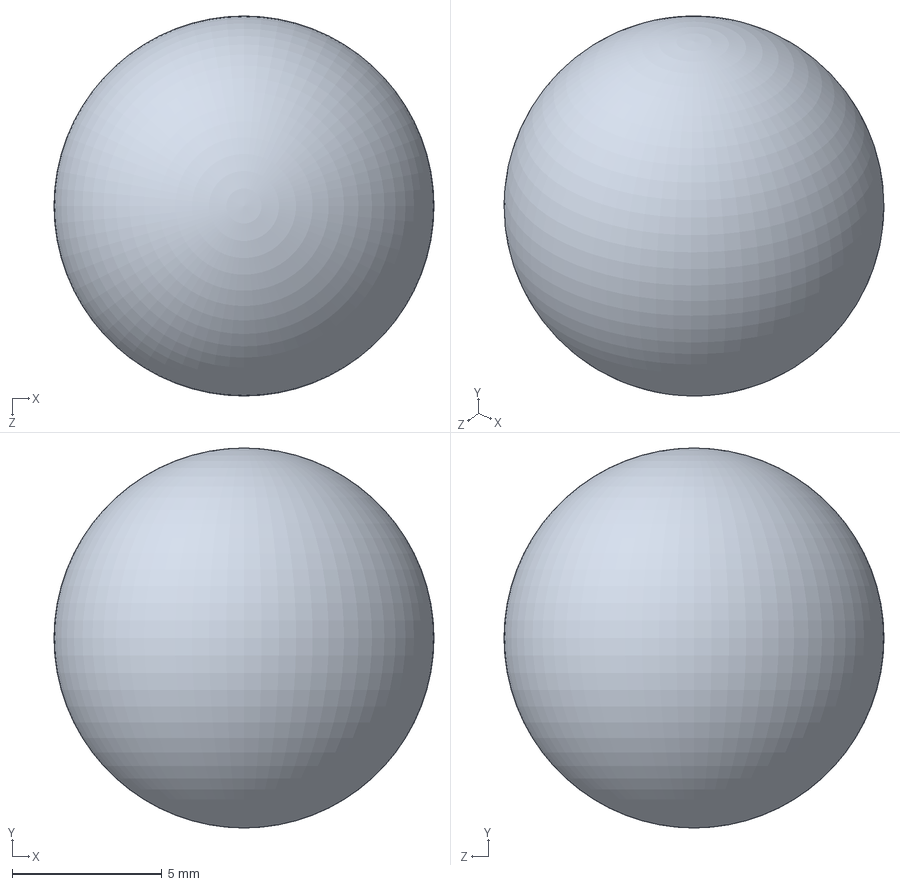
[picture p87: CAD file, 2023-12-15]
Final CAD Files/Weight Bearing Ball.SLDPRT
12.7 x 12.7 x 12.7 mm
