tlee10333/card-dealer-final-project/Pivot Arm New Wheel.SLDPRT

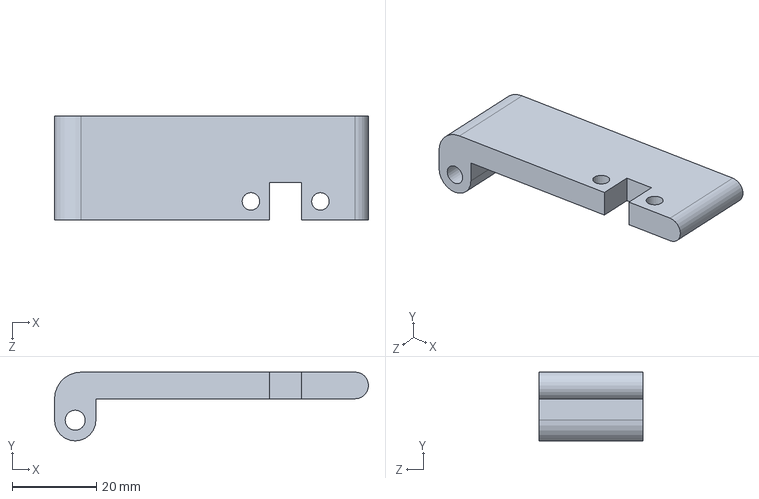
[picture p88: CAD file, 2023-11-14]
Pivot Arm New Wheel.SLDPRT
74.6 x 16.4 x 24.8 mm
