tlee10333/card-dealer-final-project/Pivot Arm Print.STL

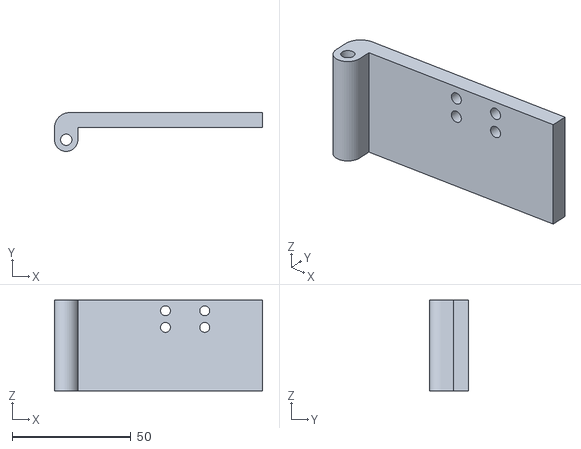
[picture p89: CAD file, 2023-11-14]
Pivot Arm Print.STL
87.5 x 16.3 x 38.1
