tlee10333/card-dealer-final-project/Final CAD Files/Weight Arm V1.STL

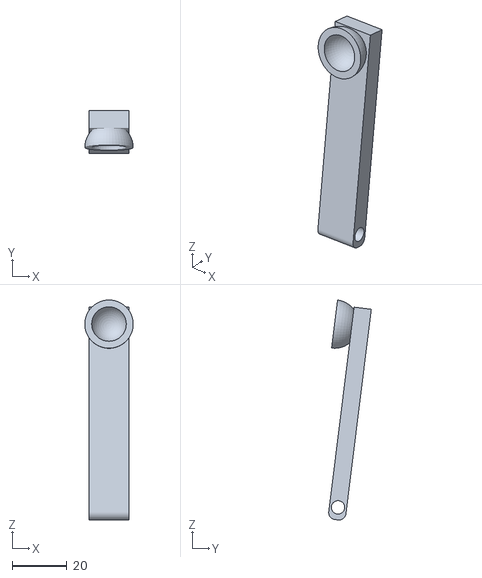
[picture p90: CAD file, 2023-12-15]
Final CAD Files/Weight Arm V1.STL
17.8 x 15.6 x 80.6
