tlee10333/card-dealer-final-project/Pivot Lever.SLDPRT

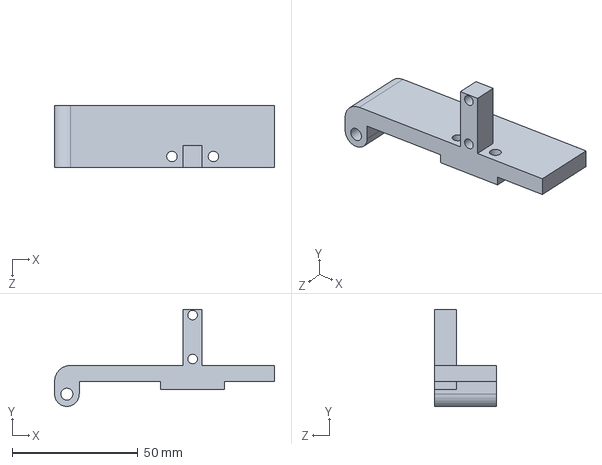
[picture p91: CAD file, 2023-11-14]
Pivot Lever.SLDPRT
87.5 x 38.6 x 24.8 mm
