tlee10333/card-dealer-final-project/Deck Holder Print.STL

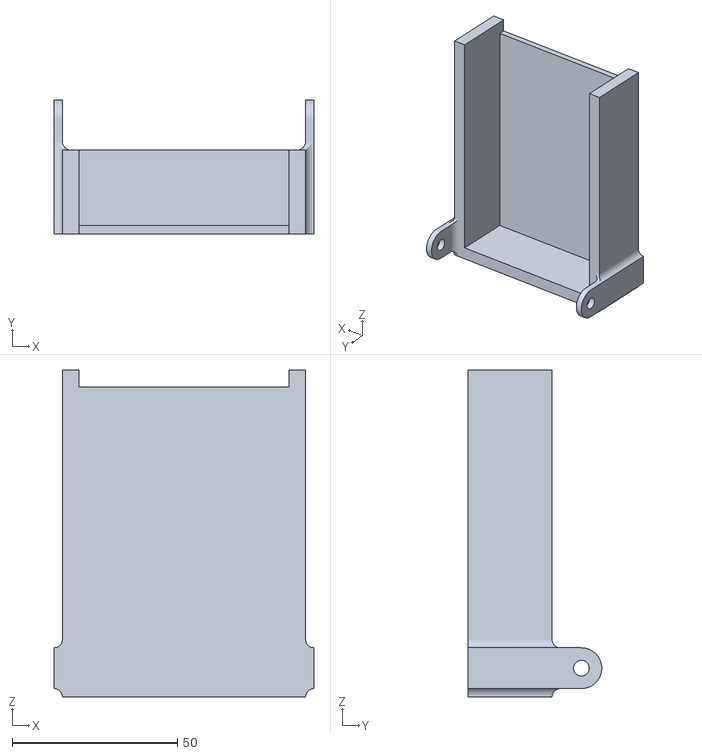
[picture p92: CAD file, 2023-11-14]
Deck Holder Print.STL
78.7 x 40.5 x 99.1
