tlee10333/card-dealer-final-project/Final CAD Files/Dealer Shroud.SLDPRT

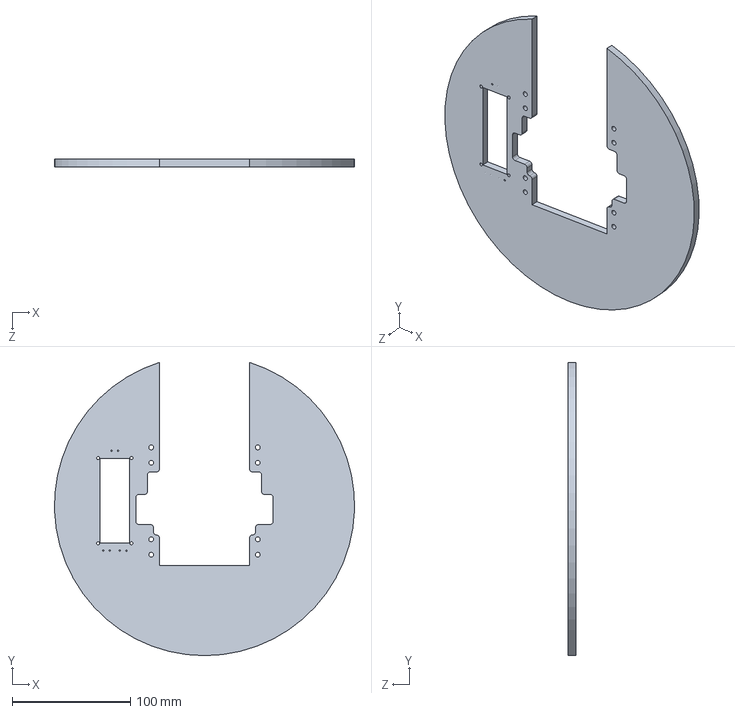
[picture p93: CAD file, 2023-12-09]
Final CAD Files/Dealer Shroud.SLDPRT
253.9 x 248.2 x 6.35 mm
