tlee10333/card-dealer-final-project/pololu-wheel-40x7mm-red.SLDPRT

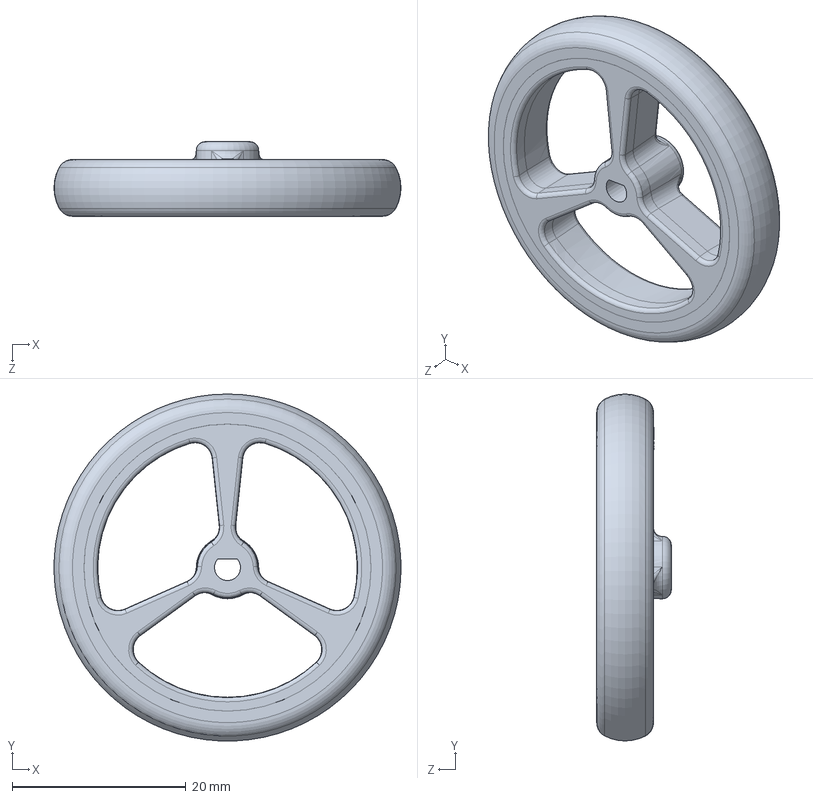
[picture p94: CAD file, 2023-11-09]
pololu-wheel-40x7mm-red.SLDPRT
40.0 x 40.0 x 8.60 mm
