tlee10333/card-dealer-final-project/Final CAD Files/button.SLDPRT

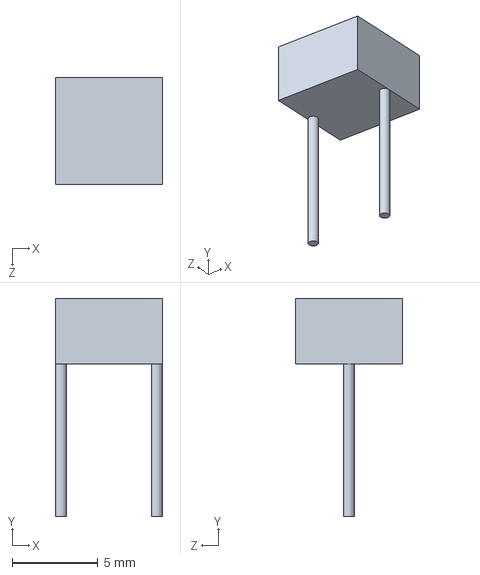
[picture p95: CAD file, 2023-12-09]
Final CAD Files/button.SLDPRT
6.22 x 12.7 x 6.22 mm
