tlee10333/card-dealer-final-project/Final CAD Files/LCD_screen.SLDPRT

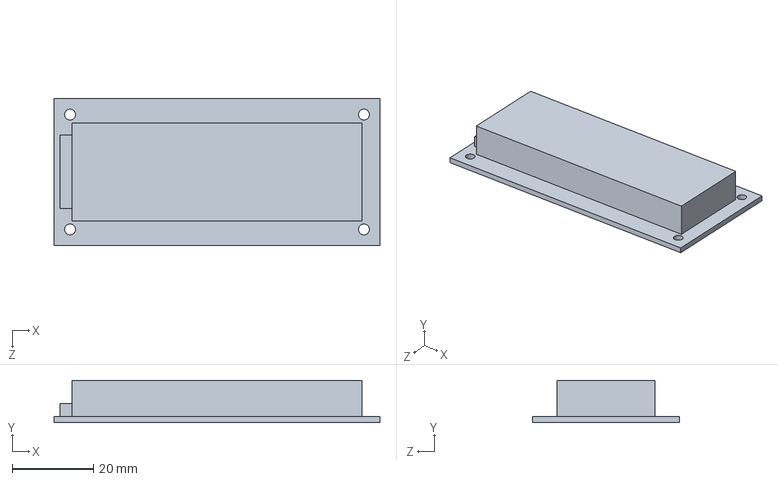
[picture p96: CAD file, 2023-12-09]
Final CAD Files/LCD_screen.SLDPRT
80.0 x 10.4 x 36.1 mm
