tlee10333/card-dealer-final-project/Final CAD Files/3mm_gear_spacer.SLDPRT

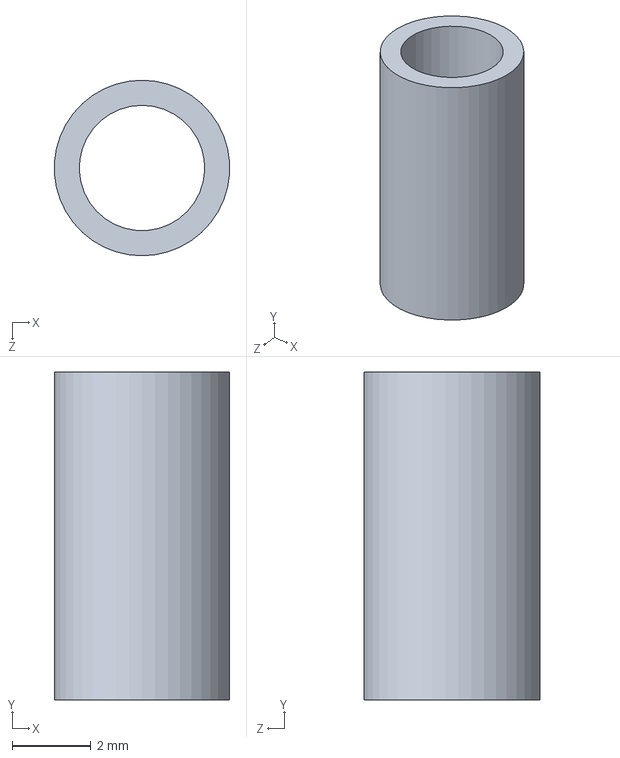
[picture p97: CAD file, 2023-12-06]
Final CAD Files/3mm_gear_spacer.SLDPRT
4.43 x 8.31 x 4.45 mm
