tlee10333/card-dealer-final-project/Final CAD Files/stepper_shaft_spacer.SLDPRT

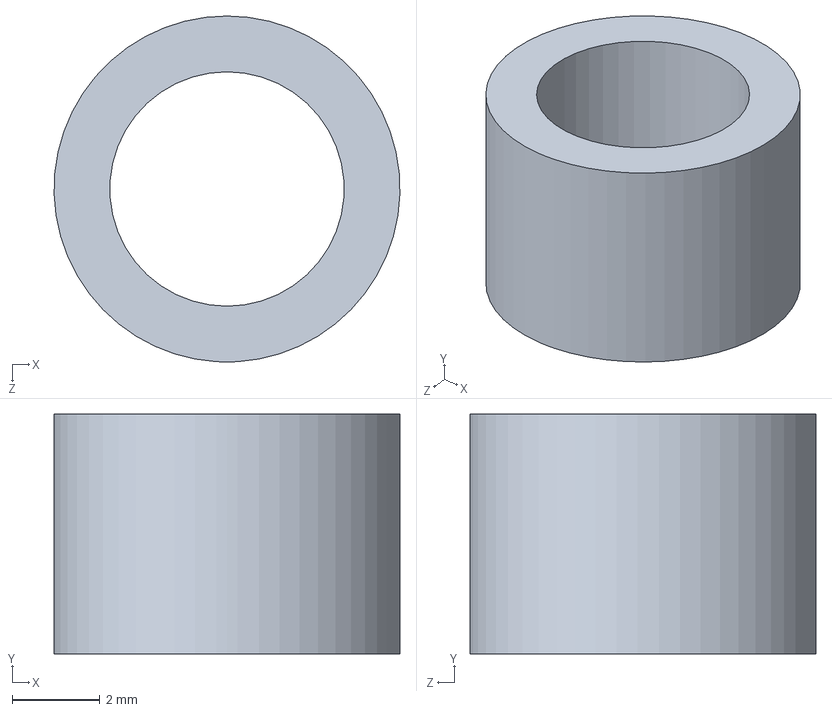
[picture p98: CAD file, 2023-12-06]
Final CAD Files/stepper_shaft_spacer.SLDPRT
7.87 x 5.46 x 7.87 mm
