tlee10333/card-dealer-final-project/MP3 Motor Shaft.SLDPRT

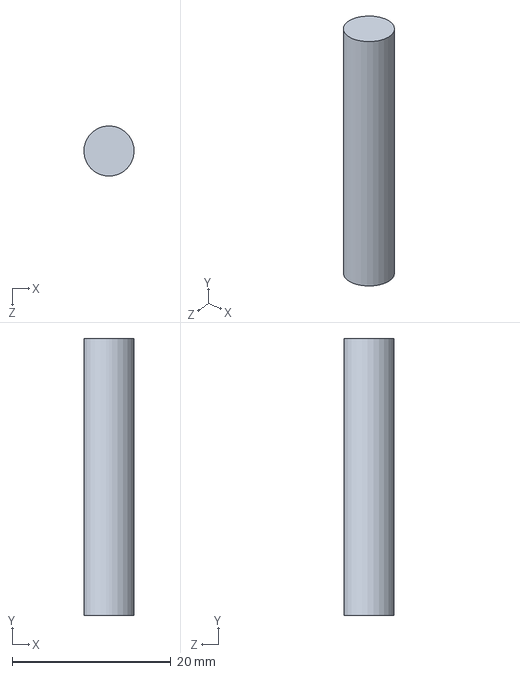
[picture p99: CAD file, 2023-10-23]
MP3 Motor Shaft.SLDPRT
6.34 x 34.9 x 6.35 mm
