tlee10333/card-dealer-final-project/Final CAD Files/Shooter Table.SLDPRT

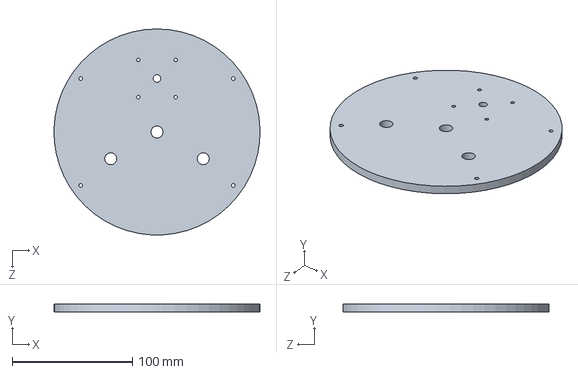
[picture p100: CAD file, 2023-12-06]
Final CAD Files/Shooter Table.SLDPRT
171.4 x 6.35 x 171.4 mm
