tlee10333/card-dealer-final-project/MP3 Motor Body.SLDPRT

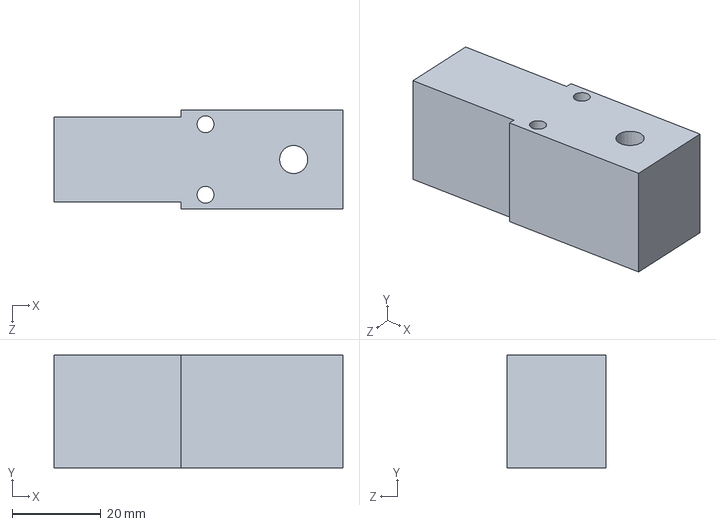
[picture p101: CAD file, 2023-10-23]
MP3 Motor Body.SLDPRT
65.1 x 25.4 x 22.2 mm
