tlee10333/card-dealer-final-project/Final CAD Files/3mm_bearing.SLDPRT

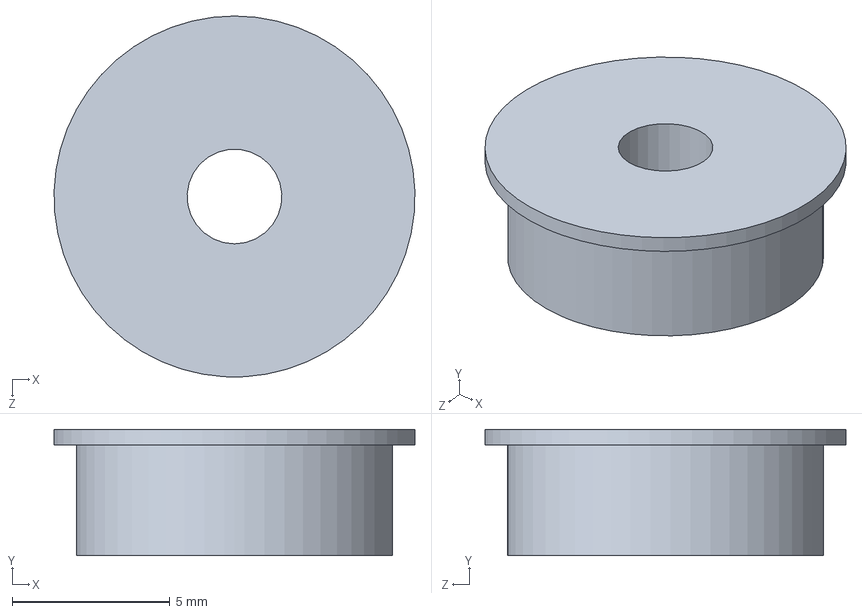
[picture p102: CAD file, 2023-12-05]
Final CAD Files/3mm_bearing.SLDPRT
11.4 x 4.00 x 11.4 mm
