tlee10333/card-dealer-final-project/MP3 Wheel.SLDPRT

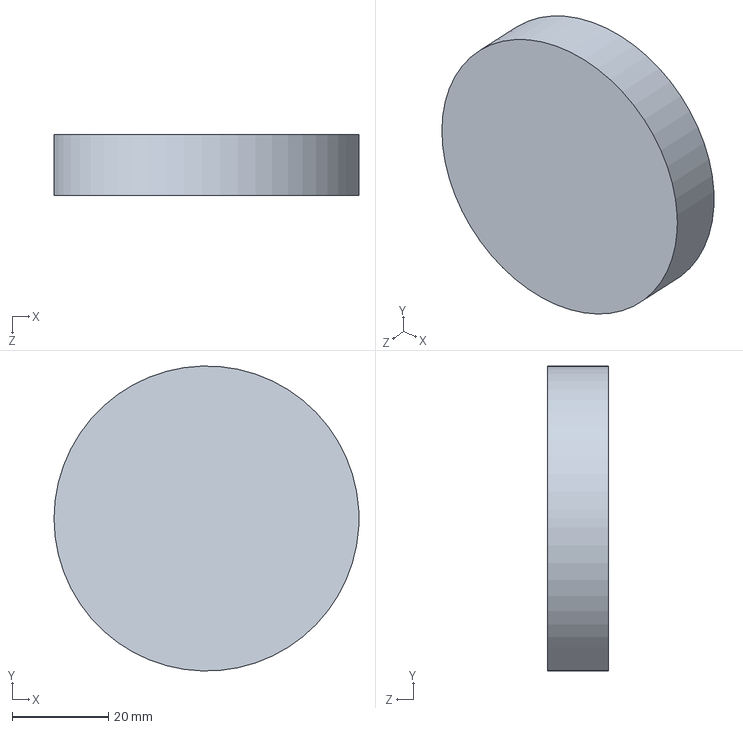
[picture p103: CAD file, 2023-10-19]
MP3 Wheel.SLDPRT
63.5 x 63.5 x 12.7 mm
