tlee10333/card-dealer-final-project/Final CAD Files/3mm_shaft.SLDPRT

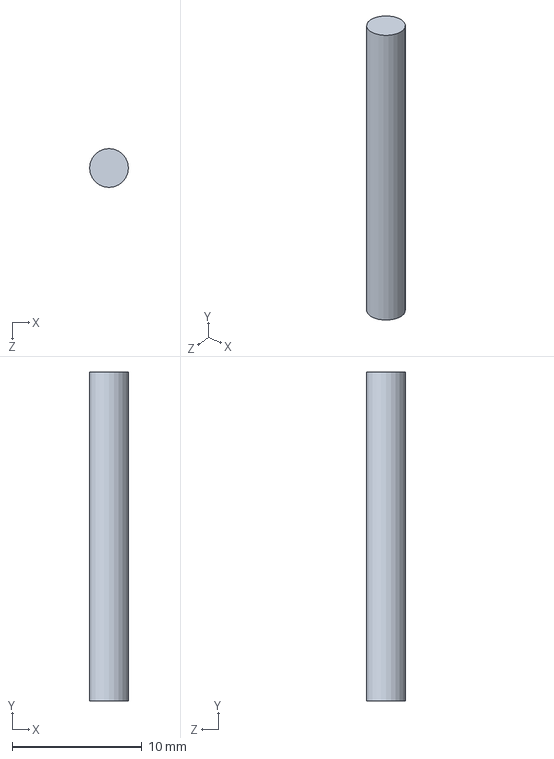
[picture p104: CAD file, 2023-12-05]
Final CAD Files/3mm_shaft.SLDPRT
3.00 x 25.4 x 3.00 mm
