tlee10333/card-dealer-final-project/Final CAD Files/Dealer Base.SLDPRT

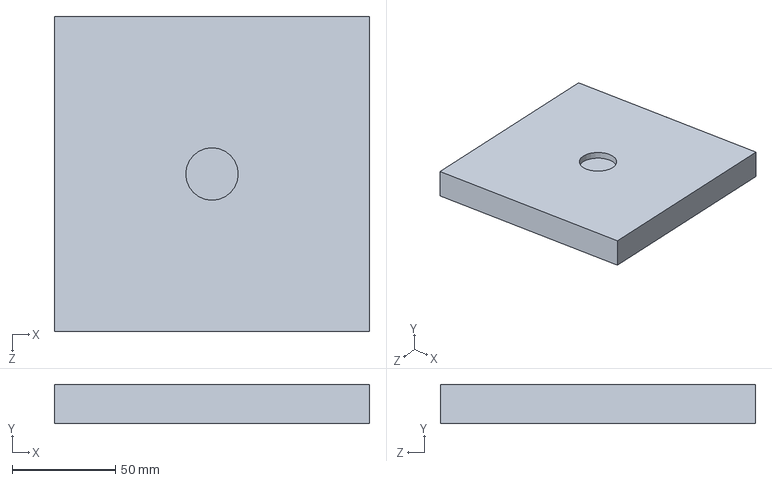
[picture p105: CAD file, 2023-11-28]
Final CAD Files/Dealer Base.SLDPRT
152.4 x 19.1 x 152.4 mm
