tlee10333/card-dealer-final-project/Final CAD Files/Shooter Center Support.SLDPRT

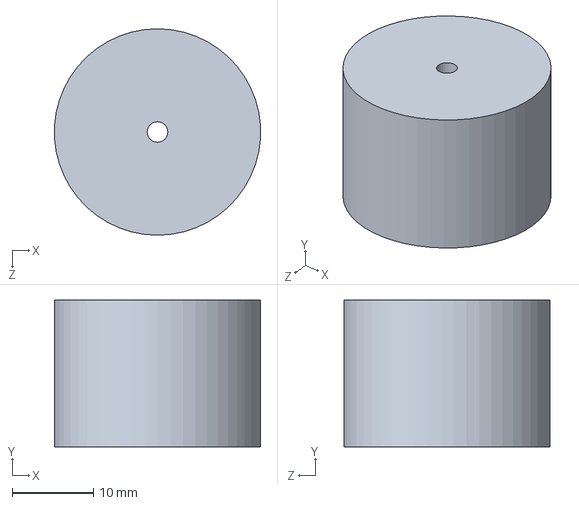
[picture p106: CAD file, 2023-11-28]
Final CAD Files/Shooter Center Support.SLDPRT
25.3 x 18.0 x 25.4 mm
