tlee10333/card-dealer-final-project/Final CAD Files/Interior Rotating Table Top.SLDPRT

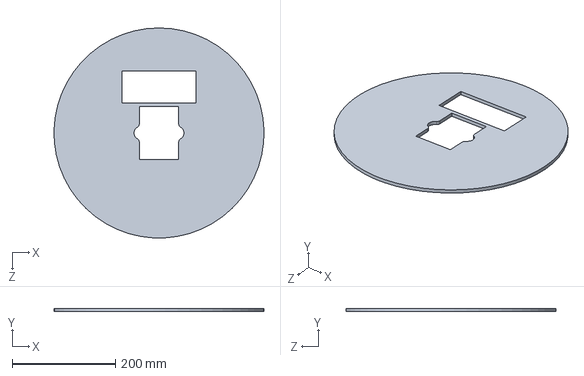
[picture p107: CAD file, 2023-11-14]
Final CAD Files/Interior Rotating Table Top.SLDPRT
406.2 x 6.35 x 406.4 mm
