tlee10333/card-dealer-final-project/Final CAD Files/New Wheel.SLDPRT

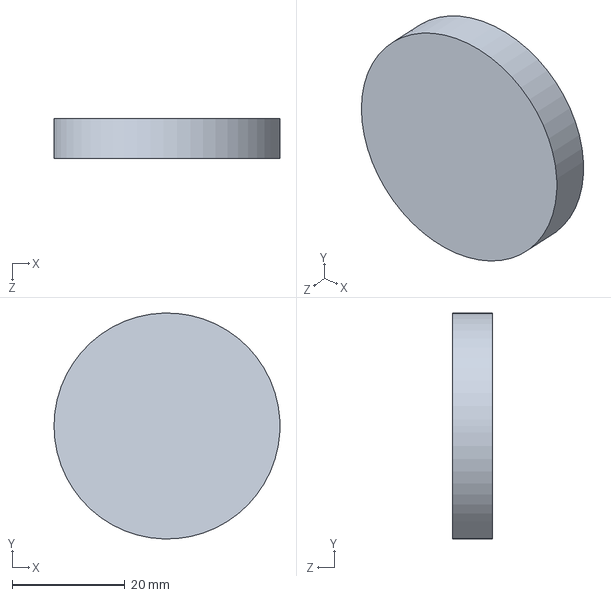
[picture p108: CAD file, 2023-11-14]
Final CAD Files/New Wheel.SLDPRT
40.0 x 40.0 x 7.00 mm
