tlee10333/card-dealer-final-project/Final CAD Files/Deck of Cards.SLDPRT

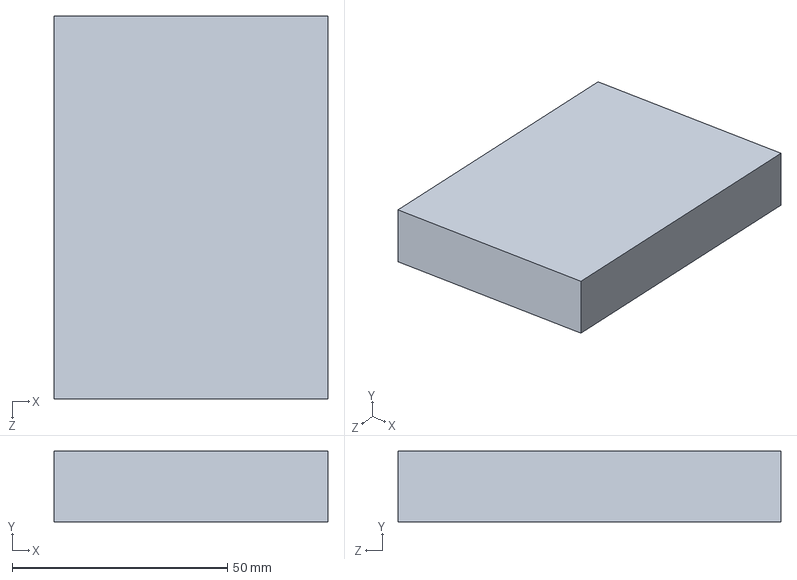
[picture p109: CAD file, 2023-11-14]
Final CAD Files/Deck of Cards.SLDPRT
63.5 x 16.4 x 88.9 mm
