tlee10333/card-dealer-final-project/Final CAD Files/Shooter Legs.SLDPRT

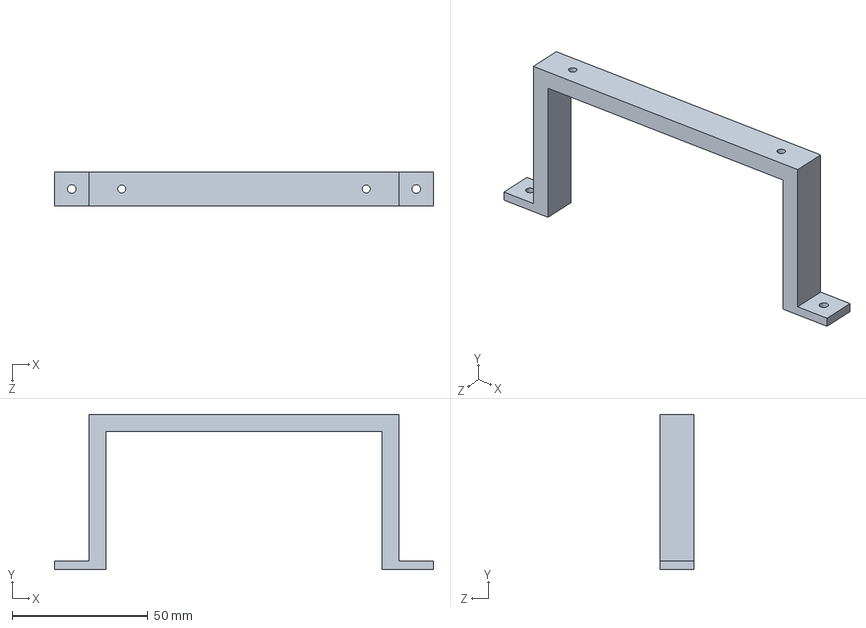
[picture p110: CAD file, 2023-11-08]
Final CAD Files/Shooter Legs.SLDPRT
139.7 x 57.1 x 12.7 mm
