tlee10333/card-dealer-final-project/Final CAD Files/Pivot Rod.SLDPRT

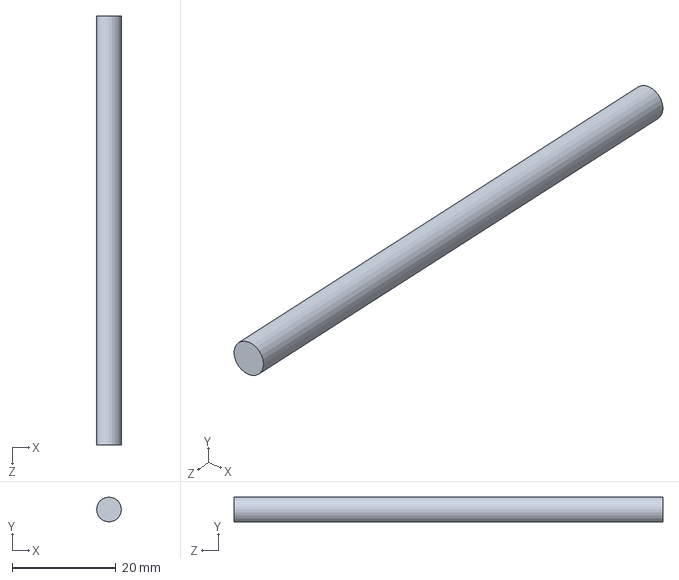
[picture p111: CAD file, 2023-10-19]
Final CAD Files/Pivot Rod.SLDPRT
4.76 x 4.76 x 82.5 mm
