tlee10333/card-dealer-final-project/(list of files, cad)

Other CAD files:
Actual Main Body.SLDPRT
Final CAD Files/Main Body Final.STL
Final CAD Files/Main Body V1.STL
Final CAD Files/Motor Mount.SLDPRT
Final CAD Files/Shaft Hold.SLDPRT
Final CAD Files/1.5mm Gate.SLDPRT
Final CAD Files/1mm Gate.SLDPRT
Motor Mount Print V2.STL
Motor Mount Print.STL
Pivot Arm.SLDPRT
Final CAD Files/Weight Arm.SLDPRT
Final CAD Files/Laser-Cut Gate.SLDPRT
Final CAD Files/Motor Coupler.SLDPRT
Deck Holder.SLDPRT
Final CAD Files/Long Weight Arm.SLDPRT
Final CAD Files/Table Top.SLDPRT
Final CAD Files/Gate Drawings.SLDDRW
Final CAD Files/grabcad_stepper/NEMA 17 Stepper Motor Assembly.IGS
Final CAD Files/grabcad_stepper/NEMA 17 Stepper Motor Assembly.SLDASM
Final CAD Files/grabcad_stepper/NEMA 17 Stepper Motor Assembly.STEP
Final CAD Files/grabcad_stepper/NEMA 17 Stepper Motor Bottom.SLDPRT
Final CAD Files/grabcad_stepper/NEMA 17 Stepper Motor Middle.SLDPRT
Final CAD Files/grabcad_stepper/NEMA 17 Stepper Motor SIMPLE.IGS
Final CAD Files/grabcad_stepper/NEMA 17 Stepper Motor Shaft.SLDPRT
Final CAD Files/grabcad_stepper/NEMA 17 Stepper Motor Top.SLDPRT
Final CAD Files/grabcad_stepper/pan cross head_am.sldprt
MP3 Motor.SLDPRT
Motor Mount New Wheel.STL
New Main Body.STL
Old CAD/Actual Main Body.SLDPRT
Old CAD/Deck Holder.SLDPRT
Old CAD/MP3 Motor.SLDPRT
Old CAD/Pivot Arm.SLDPRT
Old CAD/Prints/Motor Mount New Wheel.STL
Old CAD/Prints/Motor Mount Print V2.STL
Old CAD/Prints/Motor Mount Print.STL
Old CAD/Prints/New Main Body.STL
Old CAD/Prints/Pivot Arm New Wheel.STL
Pivot Arm New Wheel.STL
