tlee10333/card-dealer-final-project/docs/images/cadassembly-thumb.jpg

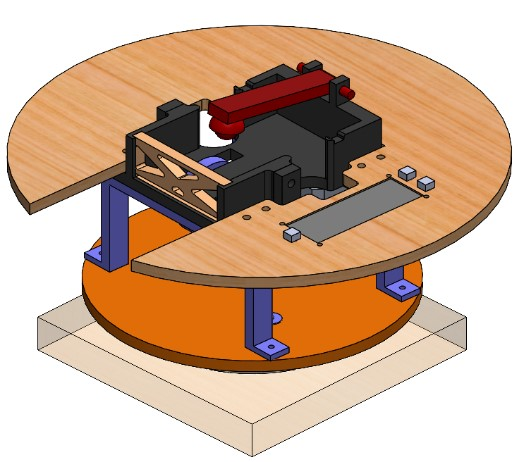
docs/images/cadassembly-thumb.jpg
