tlee10333/card-dealer-final-project/docs/images/cadassembly_table-thumb.jpg

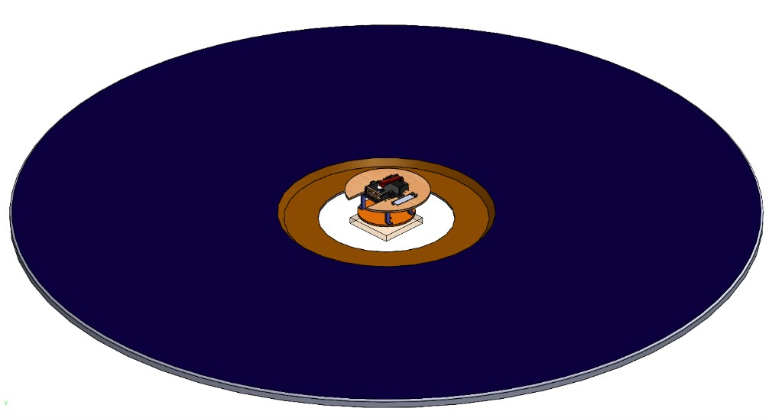
docs/images/cadassembly_table-thumb.jpg
