tlee10333/card-dealer-final-project/docs/images/test_shooter.jpg

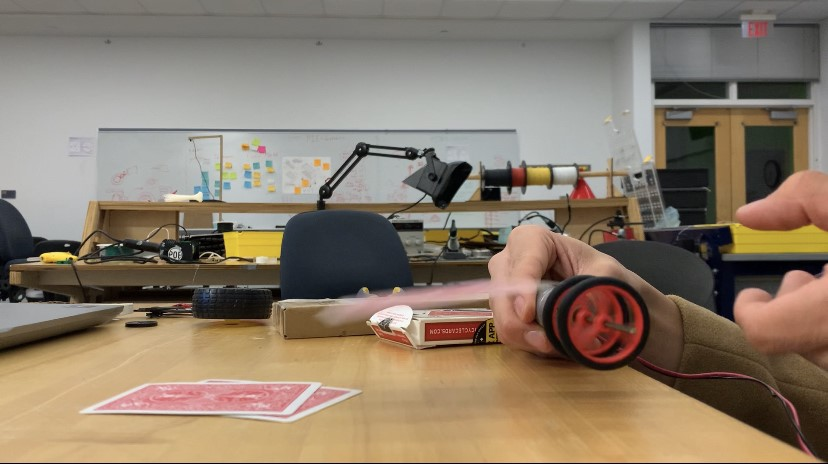
docs/images/test_shooter.jpg
