tlee10333/card-dealer-final-project/Testing Setup/DC-motor-test/DC-motor-test.ino

#include <Adafruit_MotorShield.h>

// Create the motor shield object with the default I2C address
Adafruit_MotorShield AFMS = Adafruit_MotorShield();


// Select which 'port' M1, M2, M3 or M4. In this case, M1
Adafruit_DCMotor *motor_l = AFMS.getMotor(2);


void setup() {  


  motor_l->setSpeed(30);
  Serial.begin(9600);           // set up Serial library at 9600 bps
  Serial.println("Adafruit Motorshield v2 - DC Motor test!");


  if (!AFMS.begin()) {         // create with the default frequency 1.6KHz
  // if (!AFMS.begin(1000)) {  // OR with a different frequency, say 1KHz
    Serial.println("Could not find Motor Shield. Check wiring.");
    while (1);
  }
  Serial.println("Motor Shield found.");  

}

void loop() {


  motor_l->setSpeed(30);

  motor_l-> run(FORWARD);
  delay(100);






   

}
