tlee10333/card-dealer-final-project/(commit log)

2023-10-19 Initial Card Shooter CAD
    [Card Shooter.SLDASM, Deck Holder.SLDPRT, MP3 Motor.SLDPRT, MP3 Wheel.SLDPRT, Motor Mount.SLDPRT, Pivot Arm.SLDPRT, Pivot Lever.SLDPRT, Pivot Rod.SLDPRT]
2023-10-23 Updated README & DEMO Stepper Motor Code
2023-10-23 Shooter and Pan Assembly
    [Card Shooter.SLDASM, MP3 Motor Body.SLDPRT, MP3 Motor Shaft.SLDPRT, MP3 Motor.SLDASM, Pan Gears.SLDASM, Shooter Legs.SLDPRT, Shooter Table.SLDPRT, Shooter and Pan.SLDASM]
2023-10-23 Test dc motor code
2023-10-23 check MP3 motor mounting bolt gear clearance
    [MP3 Motor.SLDASM, Shooter Table.SLDPRT, Shooter and Pan.SLDASM]
2023-10-29 Shrink internal gear, shooter legs, and table
    [Card Shooter.SLDASM, MP3 Motor.SLDASM, Shooter Legs.SLDPRT, Shooter Table.SLDPRT, Shooter and Pan.SLDASM]
2023-11-04 Add stepper motor CAD
    [NEMA 17 Stepper Motor Assembly.IGS, NEMA 17 Stepper Motor Assembly.SLDASM, NEMA 17 Stepper Motor Assembly.STEP, NEMA 17 Stepper Motor Bottom.SLDPRT, NEMA 17 Stepper Motor Middle.SLDPRT, NEMA 17 Stepper Motor SIMPLE.IGS, NEMA 17 Stepper Motor Shaft.SLDPRT, NEMA 17 Stepper Motor Top.SLDPRT]
2023-11-04 Replace dc motor with stepper motor in assembly
    [Shooter Table.SLDPRT, Shooter and Pan.SLDASM]
2023-11-08 Add deck holder mounting holes
    [Card Shooter.SLDASM, Deck Holder.SLDPRT, Motor Mount.SLDPRT, Pivot Arm.SLDPRT, Pivot Lever.SLDPRT, Shooter Legs.SLDPRT, Shooter Table.SLDPRT, Shooter and Pan.SLDASM]
2023-11-09 Add wheel connector and wheel
    [pololu-wheel-40x7mm-red.SLDPRT, wheel_connector.SLDASM, wheel_motor_connector.SLDPRT]
2023-11-09 Code for Button
2023-11-14 Redesign connector for 3mm rod
    [wheel_motor_connector.SLDPRT]
2023-11-15 added Breadboard Buttons into code
2023-11-16 Switching Jekyll Theme Template
2023-11-16 Add center hole
    [Card Shooter.SLDASM, Shooter Table.SLDPRT, Shooter and Pan.SLDASM]
2023-11-27 Update motor coupler for motor with encoder
    [wheel_motor_connector.SLDPRT]
2023-11-27 Add base and center support to shooter assembly
    [Card Shooter.SLDASM, Dealer Base.SLDPRT, Shooter Center Support.SLDPRT, Shooter Table.SLDPRT, Shooter and Pan.SLDASM]
2023-11-28 Added Buttons for HTML templates & includes
2023-11-28 Added buttons to HTML templates
2023-11-30 Initial LCD Arduino Test Code
2023-11-30 Resize holes for bearings
    [Bearing Plate.SLDPRT, Shooter Table.SLDPRT]
2023-12-04 Fully integrated Code with Encoder
2023-12-05 Add pan support gears
    [3mm_bearing.SLDPRT, 3mm_gear_spacer.SLDPRT, 3mm_shaft.SLDPRT, Card Shooter.SLDASM, Shooter Table.SLDPRT, Shooter and Pan.SLDASM, stepper_shaft_spacer.SLDPRT]
2023-12-06 Adjust shooter legs holes and spacers height
    [3mm_gear_spacer.SLDPRT, Card Shooter.SLDASM, Shooter Table.SLDPRT, Shooter and Pan.SLDASM, stepper_shaft_spacer.SLDPRT]
2023-12-08 Updated Sprint 3 Card Shooter - finger holes
    [Card Shooter.SLDASM]
2023-12-09 Make button and LCD screen profiles
    [LCD_screen.SLDPRT, button.SLDPRT]
2023-12-09 Make shroud with LCD and button holes and add to assembly
    [Card Shooter.SLDASM, Dealer Shroud.SLDPRT, Shooter and Pan.SLDASM]
2023-12-09 Shroud Clearance Cutouts & Mount Holes
    [Dealer Shroud.SLDPRT]
2023-12-09 Updated Full Assembly
    [Dealer Shroud.SLDPRT, Shooter and Pan.SLDASM, Sprint 3 Assembly.SLDASM]
2023-12-14 Sample insert image code
2023-12-15 Organize CAD files
    [3mm_bearing.SLDPRT, 3mm_gear_spacer.SLDPRT, 3mm_shaft.SLDPRT, Actual Main Body.SLDPRT, Bearing Plate.SLDPRT, Card Shooter.SLDASM, Dealer Base.SLDPRT, Dealer Shroud.SLDPRT]
2023-12-15 Upload missing CAD Files
    [0.5mm Gate.SLDPRT, 1.5mm Gate.SLDPRT, 1mm Gate.SLDPRT, 2mm Gate.SLDPRT, 5mm Gate.SLDPRT, Encoder Motor.SLDPRT, Gate Drawings.SLDDRW, Laser-Cut Gate.SLDPRT]
2023-12-15 Add correct motor mount
    [Motor Mount.SLDPRT]
2023-12-15 Fix motor mount CAD issue
    [Motor Mount.SLDPRT]
2023-12-15 Upload updated assembly
    [Sprint 3 Assembly.SLDASM]
